Tony-Stank-shift/Rescue-team/docs/vision/vision_photos/图4.png

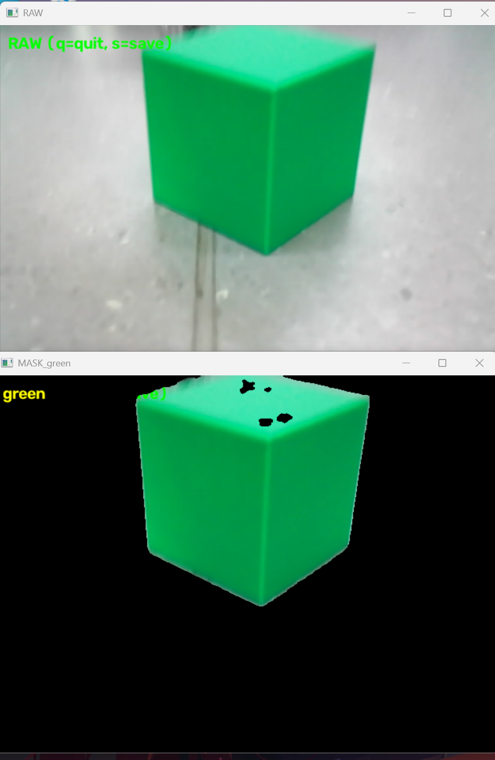
docs/vision/vision_photos/图4.png
