Tony-Stank-shift/Rescue-team/docs/vision/vision_photos/图3.png

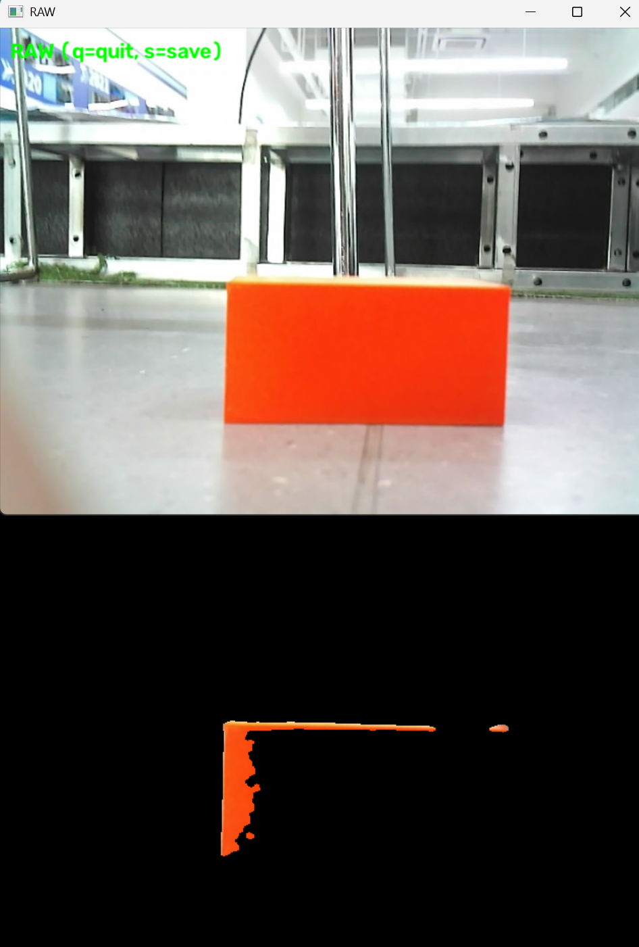
docs/vision/vision_photos/图3.png
