Tony-Stank-shift/Rescue-team/docs/GRIPPER_V2_GEOMETRY.md

# 夹爪 V2 机构几何与标定（2026-09-16 机构变更）

> **为什么有这份文档**：夹爪从旧"U 型槽 + 舵机带单块后方板渐进上调"改为
> "**150×100 方形套框 + 后方三块水平阶梯板**"。开口尺寸与板子高度直接决定
> `config.Placement` 的几个常量，而这些常量**填错就是现场套不住/放不进**。
> 本文记录**从 STL 实测得到的硬数据**、每个受影响的代码点、以及**只能真机标定**
> 的剩余项与标定方法。

---

## 1. 机构描述（机构组 2026-09-16 确认）

| 项 | 内容 |
|---|---|
| 套取方式 | **不变**：自上而下套住目标 |
| 舵机行程 | 实机标定：`0°` 套住 / `85°` 释放（对齐下位机 `servo.h`） |
| 套取开口 | **150mm(横向) × 100mm(前后)** 的方形框（旧描述里的"U 型槽"已不存在） |
| 后方阶梯板 | **三块平行于地面的水平实心板**，自上而下依次变小 |
| 单趟容量 | **1**（机构组确认，未变） |
| 板子分工 | **上板 + 中板** → 推 **橙色长方体（伤员）**、**绿色正方体（普通物资）**<br>**下板（最小）+ 中板** → 推 **黑色三棱锥（核心物资）** |

> 阶梯板是**固定件**：哪块板受力由目标高度决定，属被动机构，**软件无需选择**。
> 变化在于——旧代码里"舵机带着单块后方板**渐进上调**跨过紫边斜坡"的那套动作，
> 其**升降来源已由舵机改为这三块固定阶梯板**（详见 §4）。

---

## 2. 实测数据（源：`装配体3 - 夹爪-2-2.STL`）

测量方法可复现：`python3 tools/stl_gripper_probe.py "<STL 路径>"`

```
三角形 2600 个（二进制 STL，130084 字节，无退化面）
```

### 2.1 包围盒

| 轴 | 范围 (mm) | 跨度 | 含义 |
|---|---|---|---|
| **X** | 58.55 .. 218.55 | **160.00** | 横向（车体左右） |
| **Y** | 14.23 .. 74.89 | **60.66** | **竖直（上）** |
| **Z** | 1215.35 .. 1360.35 | **145.00** | 纵深（车体前后） |

### 2.2 坐标系是怎么定出来的（重要，别再搞错）

STL 里**没有**任何坐标轴元信息，一开始按"Z 向上"解读时三块板的大小**毫无规律**。
判据是：**只有以 Y 为"上"**时，三块水平板的尺寸自上而下恰好是
`157×40 → 150×35 → 150×20`，**依次递减**，与机构组"从上往下依次变小、
最下面最小"的描述完全吻合；换任何别的轴都得不到该规律。
同时该解读下开口尺寸正好是 **150.0 × 100.0**，与"15cm×10cm"一致。

⚠️ Z 从 1215 起，说明该装配体是**在整机装配坐标下建模**的，
故板子的**绝对离地高度未知**，安装偏置须真机实测（见 §5）。

### 2.3 套取开口

由两片侧壁与上下两面围成：

| 面 | 法线 | 尺寸 | 位置 |
|---|---|---|---|
| 左侧壁 | (1,0,0) | Y 10 × Z 100 | X = 63.5 |
| 右侧壁 | (1,0,0) | Y 10 × Z 100 | X = 213.5 |
| 前面 | (0,0,1) | X 150 × Y 10 | Z = 1355.3 |
| 后面 | (0,0,1) | X 160 × Y 10 | Z = 1360.3 |

→ **开口 = 横向 150.0mm（X 63.5..213.5）× 前后 100.0mm（Z 1255.3..1355.3）**，
竖直方向约 10mm（套框套住目标顶部的深度）。

### 2.4 后方三块水平阶梯板

| 板 | 厚度方向位置 (Y) | 长 (X) | 宽 (Z) | 与描述 |
|---|---|---|---|---|
| **上板**（最大） | 29.0 .. 32.0 | **157** | **40** | 上板 + 中板 → 伤员/普通物资 |
| **中板** | 23.2 .. 25.5 | **150** | **35** | 上板+中板 与 下板+中板 **共用** |
| **下板**（最小） | 16.5 .. 16.7 | **150** | **20** | 下板 + 中板 → 核心物资 |

三块板上表面高度差 ≈ 6~7mm、顶面高度约在 Y 17 / 24 / 30，
即**自上而下递减**，与"从上往下大小依次减小、最下面最小"一致 ✅

> 探测脚本的水平面分层表里，某些高度会同时出现**外框边沿**与**内板**的共面
> 三角形而被并成一层（例如 Y 23~25 会显示 160×110）——那是最外框的轮廓，
> 不是中板。板的真实长宽以本节表格（读自竖直面 + 共面两面配对）为准。

---

## 3. 受影响的代码点与改动

| # | 位置 | 旧 | 新 | 依据 |
|---|---|---|---|---|
| 1 | `config.Placement.SLEEVE_OPENING_MM` | 无（不存在该概念） | `(150.0, 100.0)` | §2.3 实测 |
| 2 | `config.Placement.CAPTURE_RADIUS_MM` | `150.0`（本来硬编码在 `transport_pipeline`） | **`100.0`** | §4.1 推导 |
| 3 | `config.Placement.PROGRESSIVE_RAISE_STEPS` | 硬编码 `_place_steps = 4` | 可配置，默认 `4` | §4.2 |
| 4 | `config_loader.PlacementConfig.drop_forward_mm` | 数据类默认 **`150.0`**（N-6 证明的坏值） | **`70.0`** | 见 §4.3 |
| 5 | `transport_pipeline.drop_position()` 兜底值 | `getattr(..., 150.0)`（误导性坏兜底） | `getattr(..., 70.0)` | 见 §4.3 |
| 6 | `config/robot.default.yaml` | 旧注释 + 无新键 | 三新键 + V2 说明 | — |
| 7 | `config_loader._ROBOT_SCHEMA` | 无新键校验 | 三新键校验 | 防写错静默退化 |
| 8 | 全仓 `U 型槽` 文案 | 7 处 | 改为"套取框 / 夹爪 V2" | 描述已与实物不符 |
| 9 | `sleeve_lift.py` 两个 `place_ramp()` + 类文档 | "U型槽后方实心板渐进上调" | 说明推升来源已是固定阶梯板 | §4.2 |

---

## 4. 关键推导与判断

### 4.1 `CAPTURE_RADIUS_MM`：旧值 150 对新夹爪**必然套空**

`CAPTURE_RADIUS_MM` 是"车心到目标距离小于它就开始下压套取"的闸门。
套取框中心约在车心前方 `DROP_FORWARD_MM = 70mm`，开口**半深 50mm**，因此目标与车心的
前后距离必须落在

```
[70 − 50, 70 + 50] = [20, 120] mm
```

**旧值 150 落在区间之外 → 目标根本不在套取框正下方**，而软件仍会把它记成"已套住"
（视觉确认若未标定也发现不了）——这是与 **S-40 同族的"幽灵捕获"**：记账成功、实车套空，
首趟"必须且仅 1 个普通物资"的闸门被反向废掉。

新值取 **100**：位于合法区间内、距远端边界留 20mm 余量，又不苛求导航精度达到 70。

**仿真安全性已实测**：在 `80 / 100 / 120 / 150` 四个取值下，5 种子仿真结果
**逐位完全一致**（80/7/7/E0、80/7/7/E0、85/8/8/E0…），故该改动不影响回归基线。

> ⚠️ 真机仍需确认：若导航能把目标稳定送到开口中心，可进一步下调到 **70**
> （此时两侧余量各 50mm，最大）。现场改 `config/robot.default.yaml` 的
> `placement.capture_radius_mm` 即可，无需改代码。

### 4.2 `PROGRESSIVE_RAISE_STEPS`：推升来源变了，序列需要现场二选一

旧机构：后方**单块**实心板由舵机带着**渐进上调**，把目标推上 34° 紫边斜坡。
新机构：三块**固定**阶梯板，推升靠**底盘前进**逐级爬升。

因此代码里“推入过程中舵机 0°→85° 分 4 步渐进抬”这一动作，
其**原有升力作用已消失**，只剩下"渐进卸力"的效果。两种序列都可能成立：

- `4`（默认，保留旧行为）：推入中分步渐开；
- `0`：推入全程保持 `0°`（套住），到位后一次性释放。

**这是真机标定项**，见 §5-②。改 YAML 即可切换（`placement.progressive_raise_steps`），
无需改代码。

### 4.3 顺手修掉的一个"坏默认值"埋雷

`config_loader.PlacementConfig.drop_forward_mm` 的数据类默认值写的是 **150.0**，
而 N-6 已证明 150 会把落点推到围栏上（真值 70）。`robot.default.yaml` 里写了 70.0
所以生产路径没事，但**任何漏写该项的自定义 robot YAML 都会静默拿到坏值 150**。
已把默认值改为 `70.0`，并把 `drop_position()` 里同样写死 150.0 的误导性兜底改为 70.0。

（同类问题本轮已核查：`getattr(cfg_placement, "DROP_FORWARD_MM", 150.0)` 中
`cfg_placement` 是 `config.Placement` **类**、属性必定存在，故**实际取到 70**，
过去并未真的用错——实测 `drop_position((0,0,0)) == (70.0, 0.0)` 确认。）

---

## 5. 只能真机标定的剩余项（现场按序做）

| # | 项 | 在哪改 | 怎么标 |
|---|---|---|---|
| ① | **`SLEEVE_ROI`**（套取框在相机图像中的区域） | `config/robot.default.yaml` → `perception.camera.sleeve_roi` | **最高优先级**：框没标定 → 视觉确认必失败 → 机器人卡在"失败→重试→放弃"死循环。把目标放进框，截图量框在 640×480 里的归一化 (x1,y1,x2,y2)。框变大了，旧值 `(0.32,0.55,0.68,0.98)` 大概率要改 |
| ② | **`PROGRESSIVE_RAISE_STEPS`** | `placement.progressive_raise_steps` | 分别试 `4` 与 `0`，看哪种能让目标稳定爬上紫边斜坡且不中途掉落 |
| ③ | **`CAPTURE_RADIUS_MM`** | `placement.capture_radius_mm` | 先用 100；把目标放好，手动把车开到目标正下方，量车心到目标的前后距离 → 该值应等于它；若导航偏差大就调到实测值，**绝不可 > 120** |
| ④ | **`DROP_FORWARD_MM`** | `placement.drop_forward_mm` | 目标套在框里时量车心到它的前伸距离。仍是首趟成败的决定项（见 N-6） |
| ⑤ | **`PUSH_DIST_MM`** | `placement.push_dist_mm` | 推入斜坡的距离，看目标能不能完全进到围栏内侧 |
| ⑥ | 舵机行程时间 | `sleeve_lift.MOVE_TIME_S` / `move_time_s` | 量 `SERVO,LOWER` 到实际到位的时间；**T0-6 修好串口接收缓冲后 `ACK,SERVO,LOWER` 的到达时序已变，必须重测** |
| ⑦ | 相机 `TILT_DEG` / `HEIGHT_MM` | `perception.camera.*` | 与夹爪无关，但同为未标定项（见审计 T3-19） |

---

## 6. 复现命令

```bash
# 1) 重新测量 STL 几何（机构再改时用）
python3 tools/stl_gripper_probe.py "/mnt/c/Users/.../装配体3 - 夹爪-2-2.STL"

# 2) 确认配置链路把新键读进了代码
python3 -c "
import sys; sys.path.insert(0,'src')
from rescue_robot import config as c
from rescue_robot.innovation.config_loader import RobotConfig
c.apply_robot_config(RobotConfig.from_yaml('config/robot.default.yaml'))
print(c.Placement.SLEEVE_OPENING_MM, c.Placement.CAPTURE_RADIUS_MM,
      c.Placement.PROGRESSIVE_RAISE_STEPS, c.Placement.SLEEVE_MAX_HOLD)"

# 3) 回归（改机构参数后必跑）
python3 -m compileall -q src/rescue_robot tools
PYTHONPATH=src python3 tools/fix_verifiers/run_all.py
python3 tools/hw_selftest.py --mock
PYTHONPATH=src python3 tools/fix_verifiers/snapshot_sim.py   # 基准 80/80/80/85/80
```
