Tony-Stank-shift/Rescue-team/tools/vision_vectors/README.md

# tools/vision_vectors —— 视觉识别测试向量集（⚠️ **未完成 / 待现场继续**）

> ## 状态标注（必读）
>
> **本目录是"脚手架"，不是"已验证的结论"。**
>
> 它由 AgentTeams 的 t15 任务建立，但该任务在**结项阶段被需求方主动取消**（为缩短关键路径），
> 因此：
> - **代码可运行**：`run_vectors.py` 在本机能跑通并给出有意义的输出（exit 0）；
> - **但结论未闭环**：逐样本"期望 / 实际 / 是否一致"的对照表、`通过 N/M` 的汇总、
>   以及 HSV 现场标定对照表**都没有写完**，`docs/vision/VISION_VECTORS.md` **未产出**；
> - **不得**把本目录的输出当作"识别已达标"的验收证据。它现在的用途是：
>   ① 作为**现场用 `tools/vision_calibration.py` 标定 HSV 的标尺**；
>   ② 作为后续继续完善测试向量集的**起点**。
>
> 需求方（软件负责人）的指示原文是："一并提交并加注『未完成/待现场继续』"。

## 目录内容

| 文件 | 作用 |
|---|---|
| `generate_vectors.py` | 确定性合成图生成（固定种子、不依赖摄像头/网络），产出 `img/*.png` |
| `samples.py` | 样本定义（颜色 × 形状 × 尺寸，含回归样本） |
| `run_vectors.py` | 逐样本跑当前 `detection.py` 的 HSV 判定，打印颜色中心与命中的桶 |
| `vectors.json` | 向量清单（schema / 生成者 / 是否确定性 / 帧尺寸 / 底色） |
| `img/` | 生成的样本图（36 个） |

## 现场怎么用

```bash
# 1) 看当前阈值对这批样本的判定（不需要相机）
PYTHONPATH=src python3 tools/vision_vectors/run_vectors.py

# 2) 用真实相机标定 HSV（现场灯光下）
python3 tools/vision_calibration.py
```

`run_vectors.py` 的输出里有两类**现场必须知道**的信息：

1. **参与检测的颜色桶是有顺序的**：初赛/决赛当前都是
   `['LIGHT_BLUE', 'GREEN', 'BLACK', 'ORANGE']`。
2. **BLUE 与 LIGHT_BLUE 的 HSV 桶在 H∈[95,110] 区间重叠**，重叠区由**检测顺序**决定取
   `LIGHT_BLUE`（即被判成**危险目标**）。这是**必须现场标定**的项目：真机的浅蓝与蓝
   在该区间本质重叠，只能靠"浅蓝先检测 + 分类器禁止容差命中 DANGEROUS"两道闸门区分
   （见 `docs/audit/FIXES.md` 的待现场标定表）。

## 已知回归样本（延续 t15 的设计意图，供继续完善时使用）

| 样本 | 为什么必须有 |
|---|---|
| `vec_04_*_orange_cuboid_80x40.png` | 80×40 扁盒 → 必须是 `CUBOID`。旧实现与立方体判据重叠会判成 `CUBE` → **伤员必误判（丢 15 分/个）** |
| `vec_03_normal_lightblue_dangerous*.png` | 纯饱和蓝 / 浅蓝 → **绝不能**判成 `DANGEROUS` |
| `vec_05_orange_cuboid_front40x40.png` | 长方体 80 面正对短边（投影 40×40）—— **单目轮廓无法与正方体区分**，这是已知的**根本不可区分项**，需靠颜色 + 比赛阶段组合裁决 |

## 继续完善时请补齐

1. 逐样本对照表（期望 / 实际 / 是否一致）+ `通过 N/M` 汇总，数字必须脚本真跑出来；
2. `docs/vision/VISION_VECTORS.md`（对照表 + RGB↔HSV 实测表 + 现场标定建议）；
3. 决赛形状（圆柱 / 圆锥台 / 长方体 / 球）的样本覆盖；
4. 把"根本不可区分"的两条写进正式结论：
   - 单目轮廓无法区分「长方体 80 面正对短边（投影 40×40）」与「正方体」；
   - 「立方体 vs 球」的圆度不可分。
