Tony-Stank-shift/Rescue-team/MEMORY.md

# MEMORY.md —— 软件任务清单

> **智能救援机器人 · 软件负责人**
> 本文档列出软件负责人需要完成的所有任务，按模块和优先级组织。
> 核心约束：**一键启动后完全自主运行，无任何人为了预。**

---

## 目录

- [0. 核心约束与运行架构](#0-核心约束与运行架构)
- [1. 感知模块](#1-感知模块)
- [2. 自主导航模块](#2-自主导航模块)
- [3. 转运控制模块](#3-转运控制模块)
- [4. 决策与状态机](#4-决策与状态机)
- [5. 对抗策略模块](#5-对抗策略模块)
- [6. 通信模块](#6-通信模块)
- [7. 创新实践适配](#7-创新实践适配)
- [8. 系统健壮性](#8-系统健壮性)
- [9. 开发工具链与测试](#9-开发工具链与测试)
- [10. 软件里程碑](#10-软件里程碑)

---

## 0. 核心约束与运行架构

### 0.1 最关键约束

```
┌──────────────────────────────────────────────────────────────┐
│  ⚠️ 一键启动：机器人上须有明确标识的物理按钮，只有一次启动机会  │
│  ⚠️ 启动后完全自主：不能触碰机器人、不能触碰笔记本电脑        │
│  ⚠️ 不允许任何形式的遥控                                       │
│  ⚠️ 禁止抓取救援目标、禁止将目标放置在机器人上                 │
│  ⚠️ 转运方式只能为推 / 拨 / 铲                                │
└──────────────────────────────────────────────────────────────┘
```

### 0.2 两阶段运行模式

```
【调试配置阶段 — 3 分钟】              【全自主运行阶段 — 3 分钟】
                                      
  上电、传感器初始化                    按下物理按钮 → 一键启动
  传感器校准（IMU、摄像头白平衡）       模式切换：DEBUG → AUTONOMOUS
  与笔记本通信配置参数                  锁定所有外部输入
  系统自检（全传感器 + 电机检查）       实时 感知 → 决策 → 执行 循环
  放置到出发区，进入待机                完全自主运行
  等待裁判开始指令                      比赛结束 → 安全停止
```

### 0.3 软件状态机顶层设计

```
                    ┌─────────────┐
                    │  BOOT       │ 上电初始化
                    │  系统自检    │
                    └──────┬──────┘
                           │ 自检通过
                    ┌──────▼──────┐
                    │  DEBUG      │ 调试模式
                    │  配置/校准   │ ←→ 笔记本通信
                    └──────┬──────┘
                           │ 一键启动（不可逆）
                    ┌──────▼──────┐
                    │  AUTONOMOUS │ 全自主运行
                    │  锁定输入    │
                    └──────┬──────┘
                           │
          ┌────────────────┼────────────────┐
          ▼                ▼                ▼
   ┌─────────────┐ ┌─────────────┐ ┌─────────────┐
   │ FIRST_TRIP  │ │ FREE_RUN    │ │ FORCED_RST  │
   │ 首次转运     │→│ 自由转运     │←│ 被强制分离    │
   │ 1个普通物资  │ │ ≤3个/次    │ │ 回出发区重来  │
   └─────────────┘ └──────┬──────┘ └─────────────┘
                           │ 时间将尽 / 目标全清
                    ┌──────▼──────┐
                    │  END        │ 比赛结束
                    │  安全停止    │
                    └─────────────┘
```

### 0.4 需要实现的具体任务

- [x] 实现 BOOT → DEBUG → AUTONOMOUS 三态切换
- [x] 一键启动按钮的 GPIO 中断处理（防抖动、防误触）
- [x] 启动后锁定：禁用所有通信接收、禁用调试接口
- [x] 系统自检流程：传感器数据流检查、电机响应检查、电源电压检查
- [x] 启动失败处理（如传感器未就绪 → LED 指示错误，不启动）
- [x] **15秒防停保活**：分级看门狗(10s→探索/13s→保命)，不再直接淘汰

---

## 1. 感知模块

### 1.1 目标识别与分类

**功能描述**：识别场地上的救援目标，区分为四类并输出位置。

| 任务 | 详细要求 | 优先级 |
|---|---|:---:|
| 颜色识别 | 红、黄、蓝、橘、绿、棕、黑、浅蓝、白等 | P0 |
| 形状识别（初赛） | 正方体(40mm)、正三棱锥(40mm)、长方体(80×40×40mm) | P0 |
| 形状识别（决赛） | 圆柱体(φ40×60mm)、圆锥台(φ40×φ30×60mm)、长方体(80×40×40mm)、球体(φ40mm) | P0 |
| 目标分类 | 普通物资 / 核心物资 / 伤员 / 危险目标 | P0 |
| 目标定位 | 目标在场地坐标系中的 (x, y) 坐标 | P0 |
| 目标姿态估计 | 目标朝向（判断是否可推动） | P1 |

**关键挑战**：
- 初赛和决赛目标形状**完全不同**，需要两套识别模型或强泛化模型
- 颜色可能有**色差**，光照条件不确定
- 目标摆放位置和姿态**随机**
- 实际尺寸和颜色以现场为准，与文档描述可能有偏差

### 1.2 场地环境感知

| 任务 | 详细要求 | 优先级 |
|---|---|:---:|
| 安全区颜色识别 | 区分**红色**安全区和**蓝色**安全区 | P0 |
| 物资区/伤员区识别 | 安全区内分隔板识别，判断物资区 vs 伤员区 | P0 |
| 紫色围栏检测 | 安全区面场地侧紫色三角形截面围栏 | P0 |
| 出发区识别 | 洋红色出发区（1-4 号） | P1 |
| 场地边界检测 | 四周围栏（高 < 100mm） | P0 |
| 减速带检测 | 出发区前 3 根减速带（间隔 50mm） | P0 |
| 障碍物检测 | 场地上的静态障碍物 | P1 |

### 1.3 对方机器人感知

| 任务 | 详细要求 | 优先级 |
|---|---|:---:|
| 对方机器人检测 | 识别对方机器人的位置 | P0 |
| 对方机器人跟踪 | 持续跟踪对方运动轨迹 | P0 |
| 对方意图预测 | 预测对方下一步目标（用于争夺策略） | P2 |
| 接触检测 | 检测是否与对方发生物理接触 | P0 |

### 1.4 多模态传感器融合

| 任务 | 详细要求 | 优先级 |
|---|---|:---:|
| 温度传感器 | 辅助目标识别（可能有温度差异） | P2 |
| 振动传感器 | 碰撞检测、越障检测 | P2 |
| 二维码/条码读取 | 场地布置中可能的信息标识 | P2 |
| 文字/图像识别 | 场地标记、目标上附着的文字/图像 | P2 |
| **多传感器融合** | 视觉 + IMU + 里程计融合建图定位 | P0 |

### 1.5 动态目标地图

> ⚠️ **易被忽略的关键点**：无效转运的目标会被裁判**取出重新随机放置在场地中央**，目标地图不是静态的。

| 任务 | 详细要求 |
|---|---|
| 全局目标地图维护 | 持续跟踪所有已知目标的位置和状态 |
| 目标消失检测 | 检测已被转运/被移除的目标 |
| 新目标检测 | 检测被裁判重新放入场地中央的目标 |
| 地图更新策略 | 定时全扫描 vs 事件驱动更新 |
| 目标计数 | 已转运几个、场上还剩几个（用于时间策略） |

---

## 2. 自主导航模块

### 2.1 定位

| 任务 | 详细要求 | 优先级 |
|---|---|:---:|
| 场地 SLAM | 3000×3000mm 范围内的实时定位 | P0 |
| 初始定位 | 从出发区确定自身在场地中的位置 | P0 |
| **重定位** | 被强制分离后放回出发区，需重新确定位置 ⚠️ | P0 |
| 定位精度 | 目标在 cm 级别，确保转运精度 | P0 |
| 定位丢失恢复 | 传感器遮挡/失效时的退化处理 | P1 |

### 2.2 路径规划

| 任务 | 详细要求 | 优先级 |
|---|---|:---:|
| 全局路径规划 | A* / RRT 等算法，从当前位置到目标位置 | P0 |
| 局部避障 | 动态避开对方机器人和新发现的障碍物 | P0 |
| 路径优化 | 最小化空驶距离，提高转运效率 | P1 |
| 多目标路径 | 一次规划多个目标点的最优路径 | P1 |

### 2.3 运动控制

| 任务 | 详细要求 | 优先级 |
|---|---|:---:|
| 底盘驱动 | 全向/差速驱动控制 | P0 |
| 高速移动 | 在安全前提下尽可能快 | P0 |
| 精确对准 | 接近目标/安全区时的低速精确控制 | P0 |
| **越障控制** | 跨越 3 根减速带（不可绕过） | P0 |
| 防打滑 | 避免原地打滑损坏场地 | P1 |

### 2.4 禁区管理

| 任务 | 详细要求 | 优先级 |
|---|---|:---:|
| 对方安全区检测 | 不能进入对方安全区（**含压在围栏上**） | P0 |
| 对方安全区避让 | 路径规划中标记为禁区 | P0 |
| 场地边界遵守 | 不能驶出场地围栏 | P0 |
| 扣分规避 | 每次进入对方安全区 **-5 分**，可累加 | P0 |

---

## 3. 转运控制模块

### 3.1 转运机构控制

> ⚠️ **关键约束**：禁止抓取、禁止将目标放置在机器人上。只能用推/拨/铲方式。

| 任务 | 详细要求 | 优先级 |
|---|---|:---:|
| 推拨机构控制 | 推板/拨杆/铲斗的运动控制 | P0 |
| 目标接近策略 | 从哪个角度接近目标、用什么速度 | P0 |
| 防推动失败 | 目标翻滚/滑脱时的重试逻辑 | P1 |
| 力控制 | 力度适中，不损坏目标、不推出场地 | P2 |

### 3.2 数量管理

| 任务 | 详细要求 | 优先级 |
|---|---|:---:|
| **单次装载计数** | 当前这一趟推了几个目标（≤3） | P0 |
| **首次转运判定** | 是否是第一次转运（必须恰好 1 个普通物资） | P0 |
| **伤员单独转运判定** | 转运伤员时确保数量为 1 | P0 |
| 超限检测 | 超过 3 个或伤员超过 1 个 → 本轮结束 ⚠️ | P0 |
| 危险目标过滤 | 绝对避开浅蓝正方体/球体 | P0 |

### 3.3 安全区投放

| 任务 | 详细要求 | 优先级 |
|---|---|:---:|
| **物资→物资区** | 普通/核心物资放入物资区 | P0 |
| **伤员→伤员区** | 伤员放入伤员区 | P0 |
| **放错检测与预防** | 物资入伤员区或反之 = **-10 分/个** | P0 |
| "全部进入"判定 | 目标完全进入安全区内（不含围栏上）才算成功 | P0 |
| 投放精度 | 确保投放后目标不会被弹出 | P1 |

---

## 4. 决策与状态机

### 4.1 核心状态机

```
FIRST_TRIP（首次转运）
  │  规则：必须且仅转运 1 个普通物资至本队安全区物资区围栏内侧
  │  违规（>1 个无效 或 转运了非普通物资） → 本轮结束
  │  成功条件：1 个普通物资进入物资区围栏内侧
  │
  ▼
FREE_RUN（自由转运）
  │  规则：
  │  · 一次转运 ≤ 3 个救援目标（超过 → 本轮结束）
  │  · 可同时转运普通物资 + 核心物资
  │  · 伤员必须单独转运（1 个/次）
  │  · 危险目标绝对禁止触碰
  │
  ├── 时间充裕 → 优先取高分目标（伤员 15 > 核心 10 > 普通 5）
  │
  ├── 时间将尽 → 放弃低分目标，确保已装载目标完成投放
  │
  └── 所有救援目标全清 → 比赛结束
```

### 4.2 需要实现的具体任务

| 任务 | 详细要求 | 优先级 |
|---|---|:---:|
| FIRST_TRIP 状态实现 | 只允许推 1 个普通物资，其他目标绕开 | P0 |
| FREE_RUN 状态实现 | 混合转运逻辑 + 单独伤员逻辑 | P0 |
| 首次转运完成判定 | 确认 1 个普通物资已在物资区围栏内侧 | P0 |
| 目标优先级排序 | 伤员 > 核心物资 > 普通物资（考虑距离成本） | P0 |
| 时间管理策略 | 3 分钟倒计时，剩余时间不足时切换保守策略 | P1 |
| **转运无效后的恢复** | 裁判取走无效目标 → 更新地图 → 继续运行 | P1 |

### 4.3 强制分离恢复（重要边缘情况）

> 接触超过 10 秒 → 裁判将两台机器人放回各自出发区 → 计时不中断 → 继续运行

| 任务 | 详细要求 | 优先级 |
|---|---|:---:|
| **强制分离检测** | 判断是否被裁判移动了位置 | P0 |
| **出发区重定位** | 从任意出发区重新确定自身位置 | P0 |
| **任务状态保持** | 保留已完成的任务进度（不重置状态机） | P0 |
| **继续运行** | 从出发区重新出发，继续未完成的任务 | P0 |
| 多次分离处理 | 一场比赛可能被分离多次 | P1 |

### 4.4 异常检测与处理

| 任务 | 详细要求 | 优先级 |
|---|---|:---:|
| **分级看门狗保活** | 10s无动作→探索; 13s→保命; 15s→最后防线, **不淘汰** | P0 |
| 失控检测 | IMU 异常、电机不受控 → 降级保命 | P0 |
| 传感器故障降级 | 某个传感器失效时用其他传感器补偿 | P1 |
| 卡死检测与脱困 | 被障碍物或对方卡住时主动脱困 | P1 |

> ⚠️ **15秒不再导致淘汰。改为四层降级保活链 (Level 0→4)。**

### 4.5 四层降级保活链

> **核心思想**：机器人永远不能停。遇问题逐级降级，确保一直有动作。

| 层级 | 触发条件 | 行为 | 看门狗联动 |
|:----:|---|---|:---:|
| Level 0 | 正常 | 感知→决策→导航→转运 | <10s |
| Level 1 | 单次失败 | 重试（换角度/降速/重夹取, 最多3次） | — |
| Level 2 | 3次重试失败 | 放弃当前目标，选下一个最优 | — |
| Level 3 | 无目标/路径阻断 | **探索模式**：驶向场地随机位置，边移动边扫描 | ≥10s |
| Level 4 | 13s无动作 | **保命运动**：低速绕圈，只要动就不会淘汰 | ≥13s |

**降级恢复**：一旦恢复移动或检测到目标，自动回到 Level 0。

| 场景 | 原行为 | 新行为 |
|---|---|---|
| A* 路径被阻断 | 停止不动 → 15s淘汰 | 自动换目标 / 探索 |
| 未检测到目标 | WAIT等待 → 15s淘汰 | 向场地中央移动扫描 |
| 夹取失败 3 次 | IDLE等待 → 15s淘汰 | 放弃换目标 |
| 10s 无任何动作 | 等 15s 淘汰 | **立即探索** |
| 13s 无任何动作 | 等 15s 淘汰 | **保命绕圈** |

---

## 5. 对抗策略模块

### 5.1 非进攻性对抗

| 任务 | 详细要求 | 优先级 |
|---|---|:---:|
| **禁止主动进攻** | 软件不能有任何主动冲撞对方的逻辑 ⚠️ | P0 |
| 接触检测 | 识别与对方机器人的物理接触 | P0 |
| **10 秒脱离** | 接触发生后，10 秒内主动脱离（避免强制分离） | P0 |
| 脱离策略 | 后退/绕行，选择最短的脱离路径 | P0 |

### 5.2 目标争夺

| 任务 | 详细要求 | 优先级 |
|---|---|:---:|
| 对方目标预测 | 预测对方正在前往的目标 | P1 |
| 争夺决策 | 对方已接近的目标是否放弃 vs 抢先 | P1 |
| 避让 vs 抢先 | 综合评估距离、目标分值、时间 | P1 |

### 5.3 对方意外行为

| 任务 | 详细要求 | 优先级 |
|---|---|:---:|
| 对方送入目标 | 对方把目标推入我方安全区 → 白得分，**不干扰** | P1 |
| 对方阻挡 | 对方静止挡路 → 绕行而非推撞 | P0 |
| 对方主动进攻 | 检测被攻击 → 避让，不反击（反击 = 本队结束） | P0 |

---

## 6. 通信模块

### 6.1 调试模式通信（允许双向）

| 任务 | 详细要求 | 优先级 |
|---|---|:---:|
| 参数配置协议 | 笔记本 ↔ 机器人：调整识别阈值、策略参数等 | P0 |
| 传感器数据回传 | 实时查看摄像头画面、传感器读数 | P0 |
| 状态监控 | 查看当前状态机状态、目标地图、路径规划 | P0 |
| 日志下载 | 下载历史运行日志 | P1 |

### 6.2 运行模式通信（仅单向广播）

| 任务 | 详细要求 | 优先级 |
|---|---|:---:|
| 状态广播 | 定时发送当前状态（位置、已转运目标数等） | P1 |
| **不接收指令** | 启动后**禁止**接收任何来自笔记本的控制指令 | P0 |
| **不触碰约束** | 队员不能触碰笔记本（通信协议不影响此约束） | P0 |

### 6.3 通信协议设计

| 任务 | 详细要求 |
|---|---|
| 无线方案选型 | WiFi / 蓝牙 / Zigbee 等 |
| 数据格式 | JSON / Protobuf / 自定义二进制 |
| 连接稳定性 | 断线重连、超时处理 |
| 安全机制 | 确保运行模式下不会误接收指令 |

---

## 7. 创新实践适配

> ⚠️ 决赛创新实践环节：现场发布命题 → 更换零部件 → **现场编程调试** → 时间有限

### 7.1 模块化与可配置性

| 任务 | 详细要求 | 优先级 |
|---|---|:---:|
| 参数化配置系统 | YAML/JSON 配置文件：目标颜色/形状、场地参数、策略权重 | P0 |
| 初赛/决赛模型切换 | 一键切换两套目标识别模型 | P0 |
| 硬件抽象层 | 更换零部件后软件可快速适配（如电机参数、传感器标定） | P0 |
| 策略参数热更新 | 不重新编译即可调整策略参数 | P1 |

### 7.2 现场编程效率

| 任务 | 详细要求 | 优先级 |
|---|---|:---:|
| 快速部署流程 | 从修改代码到部署到机器人 < 5 分钟 | P1 |
| 调试可视化工具 | 笔记本端 GUI 查看传感器/状态机（辅助现场调试） | P1 |
| 预设策略模板 | 多套预测试过的策略配置可选 | P2 |

---

## 8. 系统健壮性

### 8.1 故障容错

| 任务 | 详细要求 |
|---|---|
| 传感器降级 | 摄像头故障 → 尝试仅用其他传感器继续；无法继续 → 安全停止 |
| 电机故障检测 | 电机堵转/空转检测 → 记录日志 |
| 通信中断 | 调试模式下通信断开不影响机器人基本运行 |
| 电源监控 | 低电量预警（比赛前充电检查） |

### 8.2 稳定性

| 任务 | 详细要求 |
|---|---|
| **2-3 场比赛稳定性** | 成绩取平均值，每场都重要，不能单场赌博式策略 |
| 长时间运行测试 | 连续 10+ 轮模拟比赛无崩溃 |
| 内存管理 | 3 分钟运行无内存泄漏 |
| 启动成功率 | 一键启动成功率 ≥ 99%（只有一次机会） |

### 8.3 日志与复盘

| 任务 | 详细要求 |
|---|---|
| 运行日志 | 记录完整的传感器数据、决策过程、状态切换（用于赛后分析） |
| 关键事件记录 | 状态切换、违规风险、接触事件等打时间戳 |
| 日志存储 | 本地 SD 卡/Flash 存储，赛后导出 |

---

## 9. 开发工具链与测试

### 9.1 仿真环境搭建

| 任务 | 详细要求 | 优先级 |
|---|---|:---:|
| 场地仿真 | 3000×3000mm 场地模型（含所有区域、围栏、减速带） | P0 |
| 目标仿真 | 四种目标的 3D 模型（初赛 + 决赛两套） | P0 |
| 对手机器人仿真 | 模拟对手行为（随机/对抗/进攻） | P1 |
| 物理引擎 | 碰撞、摩擦、目标推动等物理效果 | P1 |
| 传感器仿真 | 模拟摄像头、IMU、里程计等数据输出 | P0 |

### 9.2 测试体系

| 任务 | 详细要求 |
|---|---|
| 单元测试 | 每个模块独立测试（识别、导航、状态机、控制） |
| 集成测试 | 模块间接口测试、数据流测试 |
| 完整比赛模拟 | 从启动到结束的完整流程自动化测试 |
| 边缘情况测试 | 强制分离、无效目标、首次转运失败等 |
| 压力测试 | 多种初始条件随机组合 |
| 硬件在环测试 | 仿真 + 真实硬件联合测试 |

### 9.3 CI/CD

| 任务 | 详细要求 |
|---|---|
| 代码仓库管理 | Git 分支策略、代码审查 |
| 自动构建 | 代码提交 → 自动编译 → 运行测试 |
| 版本管理 | 比赛用软件版本锁定与备份 |

---

## 10. 软件里程碑

对齐整体项目进度（11 个 Phase），软件负责重点任务：

| Phase | 阶段 | 软件任务 | 产出物 |
|:-----:|---|---|---|
| 1 | 赛题分析 | 需求分析、软件架构设计、技术选型 | 软件架构文档 |
| 2 | 机械设计 | 传感器布局方案、计算平台选型 | 硬件-软件接口定义 |
| 3 | 硬件选型 | 确定传感器型号、安装位置标定方案 | 传感器驱动清单 |
| 4 | 装配调试 | 传感器驱动开发、基础运动控制 | 底盘可动、传感器有数据 |
| 5 | 自主导航 | SLAM、路径规划、避障、越障 | 场地内自主移动 |
| 6 | 目标识别 | 视觉模型训练、多模态融合、动态地图 | 四类目标 >95% 识别率 |
| 7 | 转运控制 | 推拨控制、数量管理、投放精度 | 成功转运目标至安全区 |
| 8 | 对抗联调 | 状态机完整实现、对抗策略、强制分离恢复 | 完整比赛流程可运行 |
| 9 | 文档撰写 | 配合撰写任务命题文档（软件部分） | 文档软件章节 |
| 10 | 模拟比赛 | 仿真全流程测试、边缘情况覆盖、稳定性验证 | 20+ 轮无故障运行 |
| 11 | 正式参赛 | 现场调试预案、应急处理方案、最终版本锁定 | 比赛就绪 |

---

## 附录 A：快速参考 —— 关键数字

| 项目 | 数值 |
|---|---|
| 场地尺寸 | 3000 × 3000 mm |
| 运行时间 | 3 分钟（180 秒） |
| 调试时间 | 3 分钟 |
| 强制分离接触时间 | 10 秒 |
| 无动作停止时间 | 15 秒 |
| 单次最多转运 | 3 个（伤员必须单独） |
| 机器人最大重量 | 1.5 kg |
| 机器人最大尺寸 | 300 × 300 × 200 mm |
| 目标最大尺寸 | 140 mm |
| 目标最大重量 | 800 g |

## 附录 B：快速参考 —— 违规后果

| 违规行为 | 后果 |
|---|---|
| 危险目标入安全区 | **本轮结束** |
| 首次转运 ≠ 1 个普通物资 | **本轮结束** |
| 单次转运 > 3 个 | **本轮结束** |
| 转运伤员 > 1 个 | **本轮结束** |
| 主动进攻 | **本轮结束** |
| 对方安全区内移出目标 | **本轮结束** |
| 物资⇔伤员区放错 | **-10 分/个** |
| 进入对方安全区 | **-5 分/次** |
| 移出场地 | 按种类扣分 |
| 15 秒无动作 | **降级保活，不淘汰**（探索→保命绕圈） |
| 失控 / 起火 / 破坏场地 | **本轮结束 + 取消资格** |

---

> 📝 **本文档随开发进展持续更新。** 每个 Phase 开始前 review 对应任务，完成后勾选。
