Tony-Stank-shift/Rescue-team/docs/hardware/EDA.png

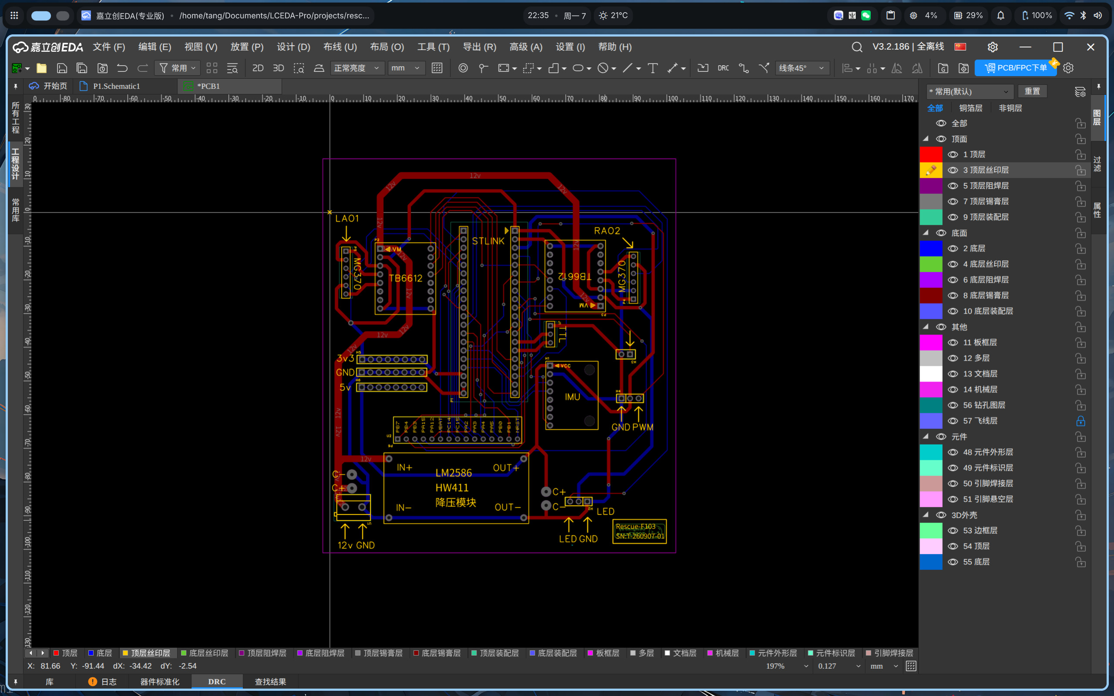
docs/hardware/EDA.png
