Tony-Stank-shift/Rescue-team/docs/scene/field_layout_diagram.png

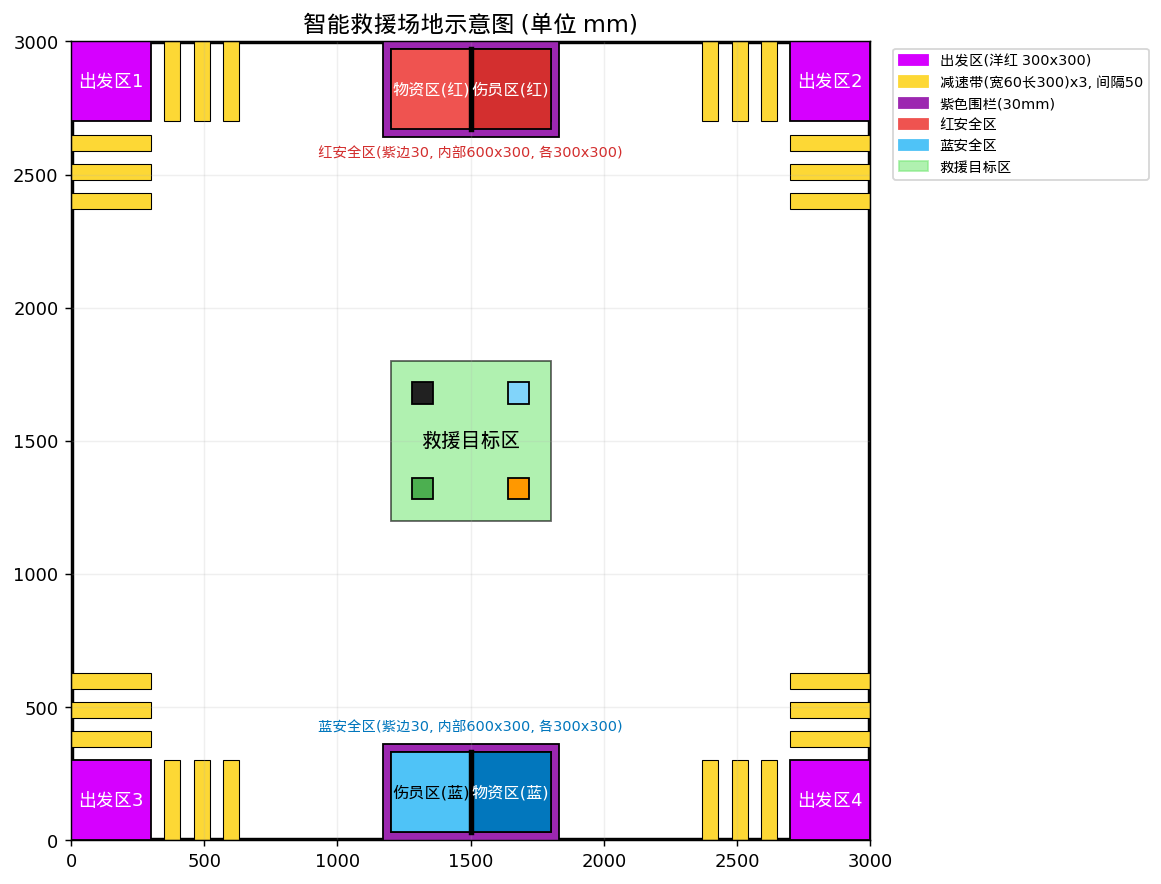
docs/scene/field_layout_diagram.png
