Tony-Stank-shift/Rescue-team/docs/scene/field_layout_v2.png

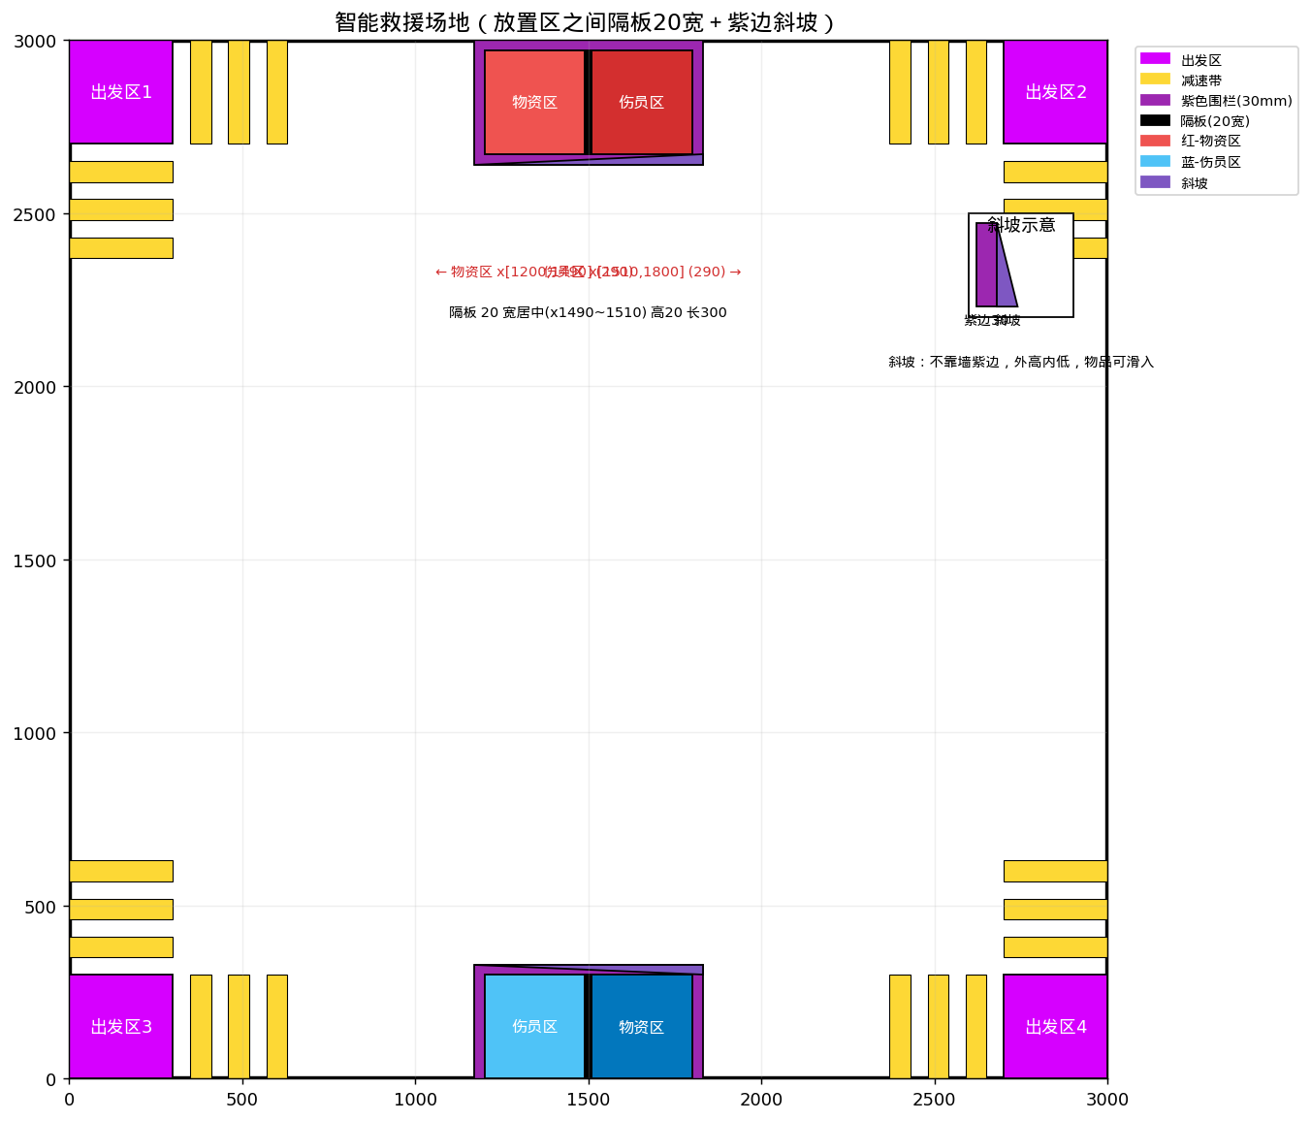
docs/scene/field_layout_v2.png
