Tony-Stank-shift/Rescue-team/docs/scene/pdf_field_page16.png

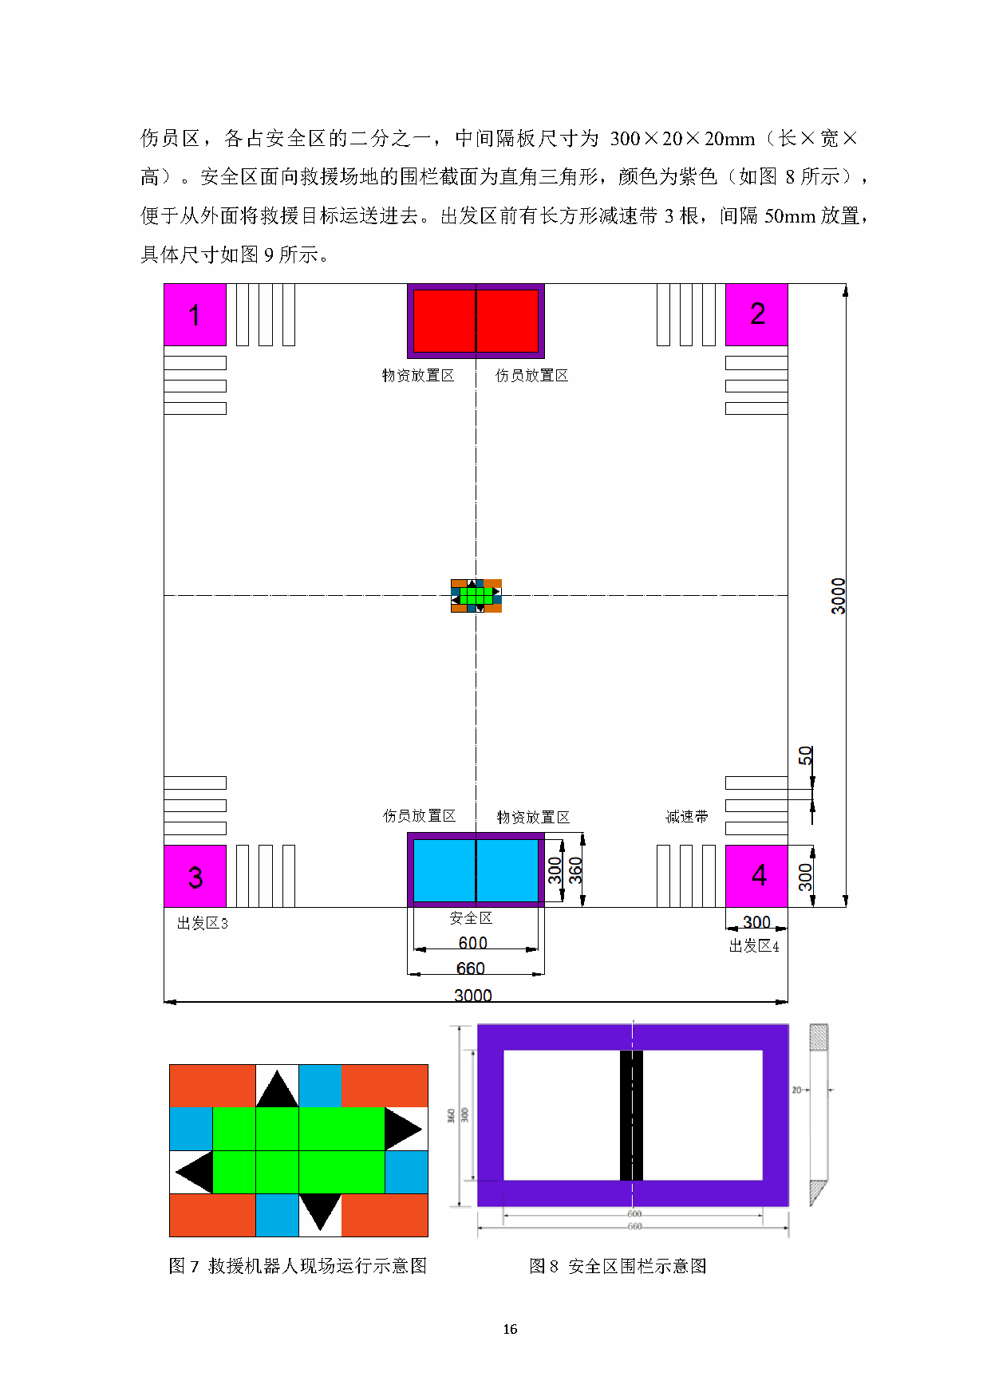
docs/scene/pdf_field_page16.png
