Tony-Stank-shift/Rescue-team/docs/vision/vision_photos/图1.png

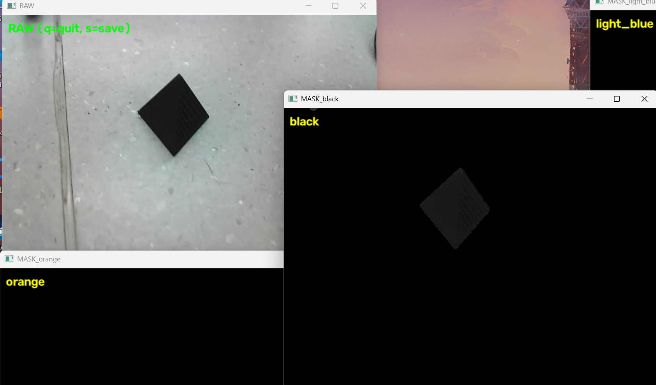
docs/vision/vision_photos/图1.png
