Tony-Stank-shift/Rescue-team/docs/vision/vision_photos/图2.png

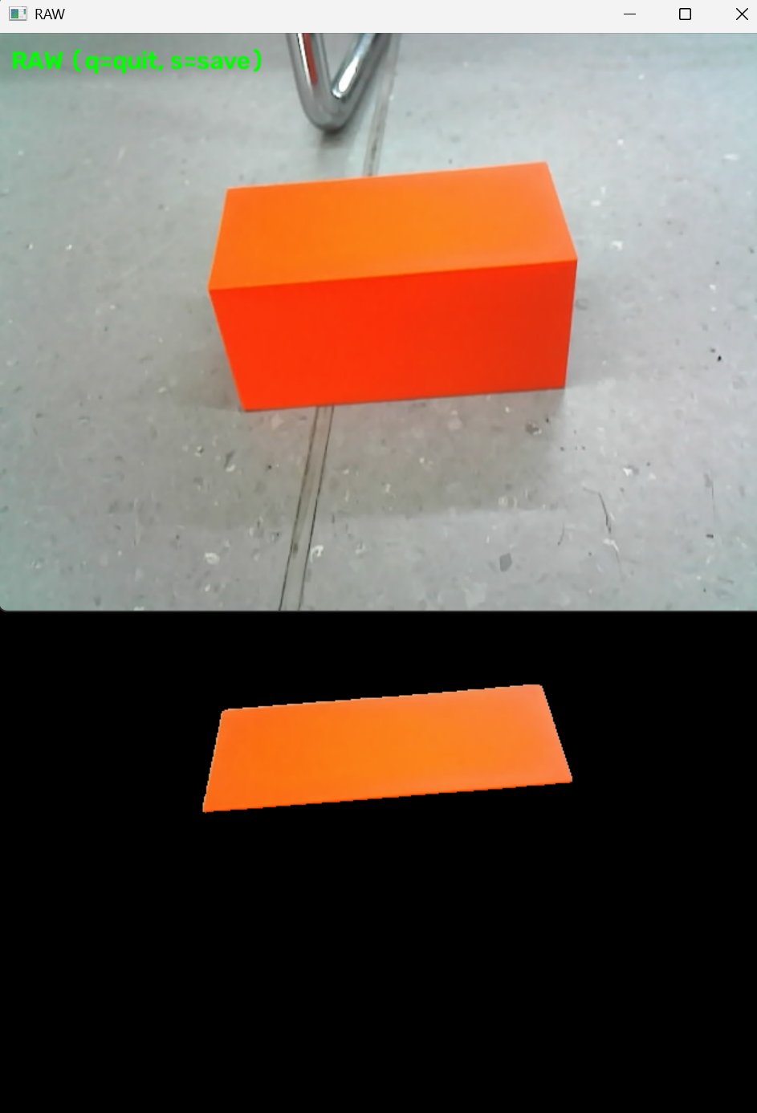
docs/vision/vision_photos/图2.png
