Tony-Stank-shift/Rescue-team/docs/vision/vision_photos/图5.png

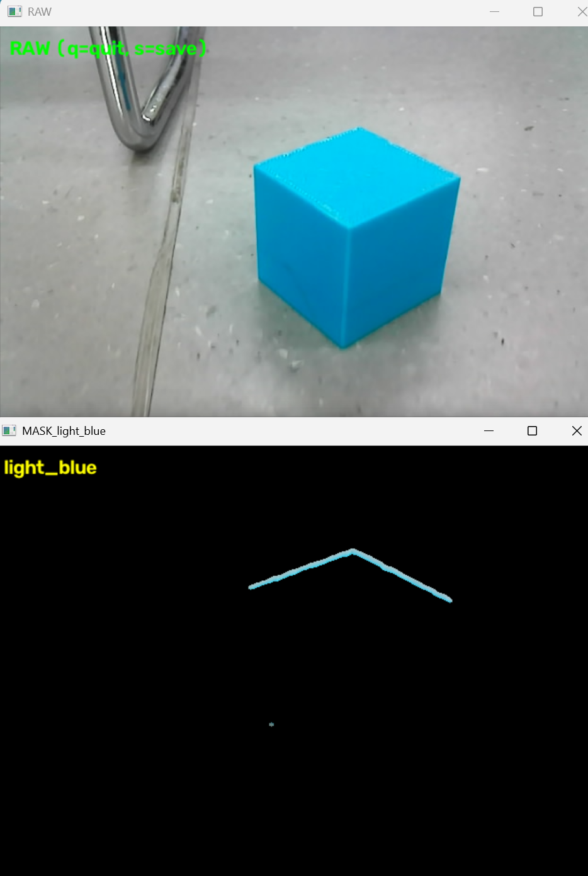
docs/vision/vision_photos/图5.png
