Tony-Stank-shift/Rescue-team/docs/vision/vision_photos/图6.png

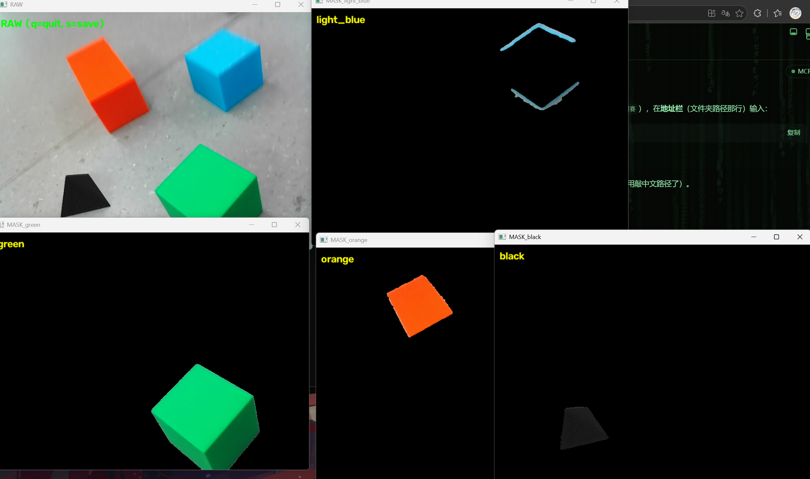
docs/vision/vision_photos/图6.png
