Tony-Stank-shift/Rescue-team/docs/vision/vision_photos/图7.png

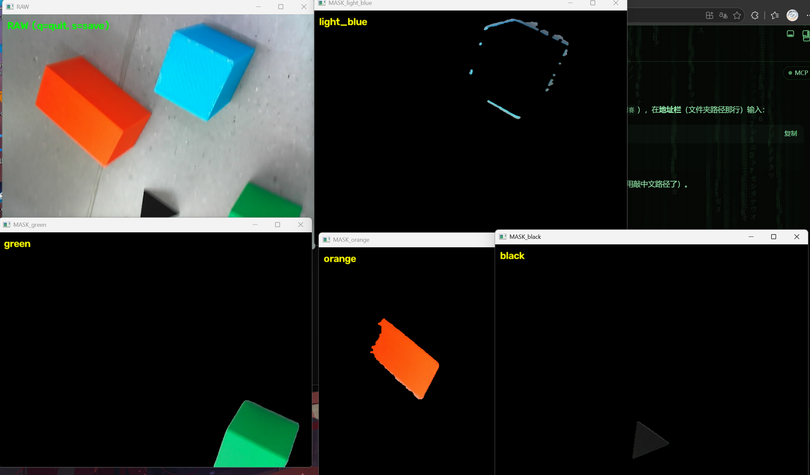
docs/vision/vision_photos/图7.png
