Tony-Stank-shift/Rescue-team/docs/vision/vision_photos/图8.png

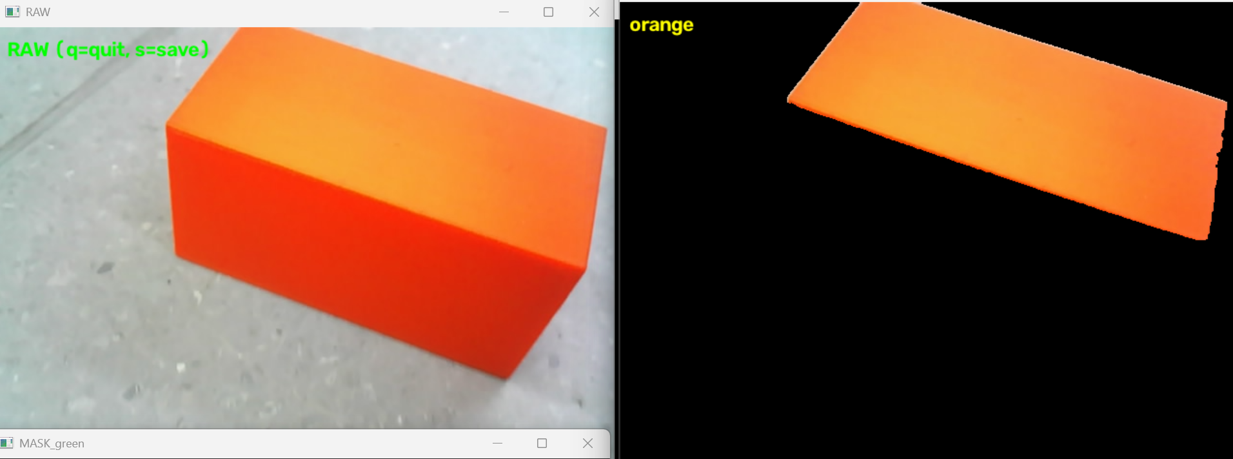
docs/vision/vision_photos/图8.png
