Tony-Stank-shift/Rescue-team/tools/vision_vectors/img/vec_02_normal_black_pyramid.png

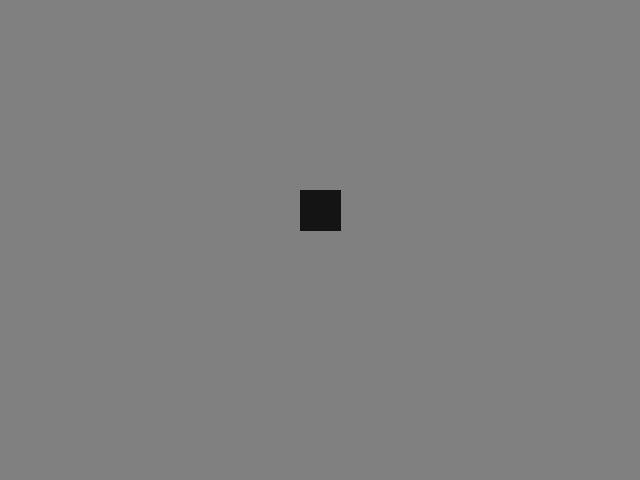
tools/vision_vectors/img/vec_02_normal_black_pyramid.png
