Tony-Stank-shift/Rescue-team/tools/vision_vectors/img/vec_12_white_background.png

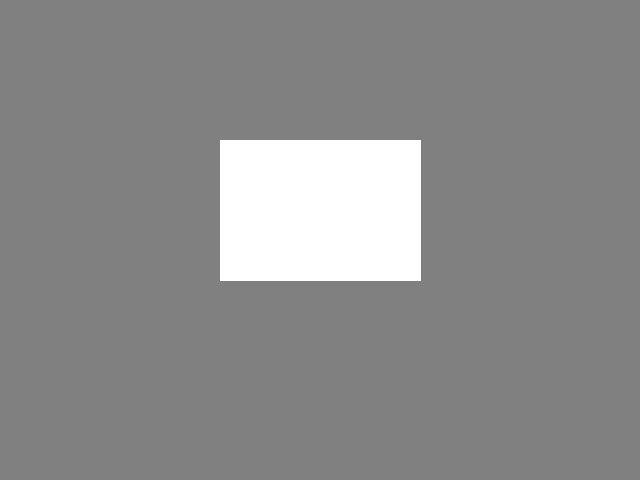
tools/vision_vectors/img/vec_12_white_background.png
