Tony-Stank-shift/Rescue-team/tools/vision_vectors/img/vec_15_lightblue_vs_blue_sbs.png

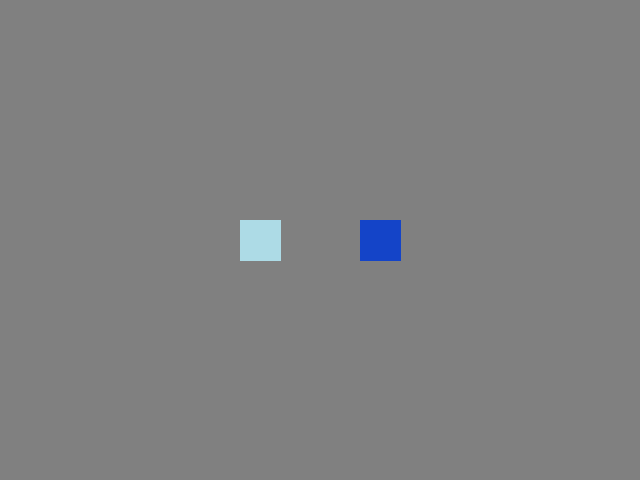
tools/vision_vectors/img/vec_15_lightblue_vs_blue_sbs.png
