Tony-Stank-shift/Rescue-team/tools/vision_vectors/img/vec_19_white_wide.png

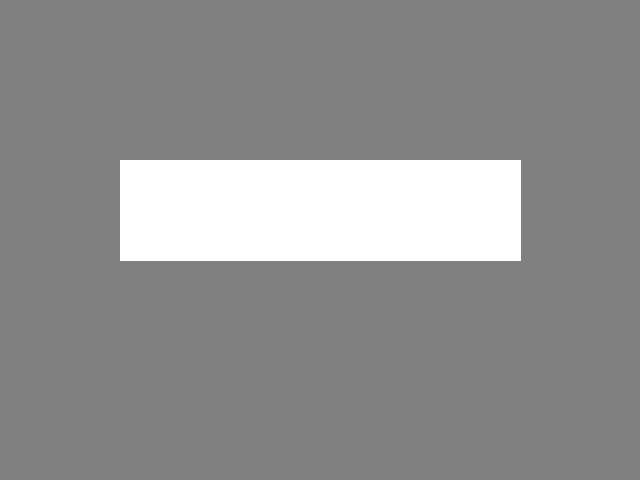
tools/vision_vectors/img/vec_19_white_wide.png
