Tony-Stank-shift/Rescue-team/docs/audit/REAL_MACHINE_DEBUG_20260916.md

# 真机联调排查与修复全记录（2026-09-16）

> **这份文档解决什么问题**：本次把上位机第一次真正接到 RDK + STM32 上跑，
> 过程中出现了一连串"看起来像硬件坏、实际是软件"的故障。每一条都记录了
> **现场现象 → 实测证据 → 根因 → 修复**，目的是让下次现场再遇到同类症状能**直接查表**，
> 而不是从头再猜一遍。
>
> 全轮共修 **9 个问题**，其中 **2 个在 STM32 固件**、**7 个在上位机**。

---

## 0. 环境事实（本轮确认）

| 项 | 值 | 怎么确认的 |
|---|---|---|
| 上位机 | RDK X5，`ubuntu`，Linux 6.1.83 aarch64 | `uname -a` |
| 连接 | 网线直连，`sunrise@192.168.50.2` | `ping` 2.8ms |
| 串口 | **`/dev/ttyS1` @115200**（40PIN UART1） | `/proc/tty/driver/serial` + 实测收发 |
| 引脚复用 | **正确**：GPIO383=RX / GPIO384=TX 属 `uart1grp` | `/sys/kernel/debug/pinctrl/34180000.lsio_iomuxc/pinmux-pins` |
| 相机 | XC-TECH UVC，640×480@16.5FPS | 实拍 + `lsusb` |
| 下位机 | STM32F103，USART1 / **PA9=TX, PA10=RX** / 115200 | CubeMX `.ioc` + `main.c` |
| 固件工具链 | STM32CubeCLT（`AppData/Local/stm32cube/bundles/`） | `CMakeCache.txt` |
| 烧录 | `STM32_Programmer_CLI.exe -c port=SWD -w ...elf -v -rst` | 实测通过 |
| 启动开关 | 下位机 STM32 板上的 **`ON` 自锁开关，接 PB9**（上拉，拨到 ON 拉低） | 协议 §5.1.1 + `main.h` |

---

## 1. 问题清单（9 条）

### 【固件-1】IMU 初始化失败 → 整个 MCU 永久死循环，遥测一字节不发

| 项 | 内容 |
|---|---|
| **现象** | 串口能打开、`rx` 计数**自开机起恒为 0**，上位机表现为"串口故障/接线问题" |
| **证据** | 裸读 `/dev/ttyS1` 3 秒 0 字节；`/proc/tty/driver/serial` 显示 uart1 `rx:0`；换 `cat`/`pyserial` 都一样 |
| **根因** | 固件 `main()` 里 `if (MPU6050_Init(&hi2c2) != HAL_OK) Error_Handler();`，而 `Error_Handler()` 是 `__disable_irq(); while(1){}` **永久死循环**；**`Telemetry_Init()` 排在它后面** → 只要 IMU 没接好/上电时序不巧（`WHO_AM_I != 0x68`），固件就卡在初始化，遥测永远发不出来 |
| **为什么难查** | 电机、串口线、RDK 全是好的，故障点在最不相干的 IMU 支路上 |
| **修复** | 固件改为**降级运行**：`(void)MPU6050_Init(&hi2c2);`（失败不致命）。下游本来就做好守卫：`MPU6050_Update()` 有 `!initialized` 早退、`MPU6050_GetLatestSample()` 无效返回 false、遥测 IMU 行自动跳过 → 没有 IMU 时定位退化为纯里程计，但机器人不再变砖 |
| **状态** | ✅ 已烧录并验证（遥测恢复 84 行/秒） |

### 【固件-2】UART 接收静默死亡（TX 正常），最长静默 6 秒以上

| 项 | 内容 |
|---|---|
| **现象** | 遥测正常流动，但对 `PING`/`START`/`VEL`/`SERVO` **一律不回**（连 `ERR,FORMAT` 都没有），持续数秒后自行恢复 |
| **证据** | 6 轮"开关串口+PING"实测：3/6 轮首次无应答；**第 5 轮连续 3 次（≥6 秒）全部无应答**；而同一时刻下位机仍在发 84 行/秒遥测 |
| **根因** | STM32 HAL 在 ORE（溢出）处理里走 `UART_EndRxTransfer()`，会清掉 `CR1` 的 `RXNEIE/PEIE` 与 `CR3` 的 `EIE`。**`EIE` 一清，后续错误连 `HAL_UART_ErrorCallback` 都不再触发** → `RxState` 停在 `BUSY_RX` 且没有任何中断推动状态机 → 接收永久失效。**而 TX 完全不受影响，所以故障极难察觉** |
| **第一版修复为什么无效** | 我最初写成 `if (RxState != HAL_UART_STATE_BUSY_RX) { 重新武装 }` —— 而故障态**恰恰就是 `BUSY_RX`**，判断直接跳过 |
| **修复** | `Command_Update()` 内加 **RX 健康看门狗**：每 `RX_HEALTH_PERIOD_MS=500ms` **无条件**强制 ①拉回 `READY` ②清 `ErrorCode` 与 ORE ③`HAL_UART_Receive_IT` 重新武装。代价是极小概率丢 1 个在途字节（VEL 50Hz 丢 1 帧无影响，PING/START 有重试） |
| **效果** | 6 秒死窗口消失；最长连续失败从 3 次降到 2 次，每次 2 秒内自愈 |
| **状态** | ✅ 已烧录 |

### 【上位机-1】`START` 不清零里程计 → 累积位移被加到出发区位姿上

| 项 | 内容 |
|---|---|
| **现象** | 进 AUTONOMOUS 后 `A*: 起点 (3973, 2160) 不可通行`（场地只有 3000×3000，即场外约 1 米）→ 路径规划永远失败 → 车一动不动 |
| **证据** | 真机实测发 `START` 前后逐位对比：<br>`前: x=+0.6823 y=+1.0959 θ=-1.7043 enc=(921273,1240079)`<br>`后: x=+0.6823 y=+1.0959 θ=-1.7043 enc=(921273,1240079)`<br>**一模一样** —— 协议 §START 声称"清零局部里程计"，**实际并没有** |
| **根因** | `ChassisInterface.odom_to_upper()` 把 ODOM 当**相对位移**用（`x = _start_x + dx`），而 MCU 上电以来的累积量没被清 → 全部被当成"从出发区走的距离"加上去 |
| **算术复现** | 起点 (2850,2850)：`2850+1096=3946`、`2850-682=2168` ≈ 日志里的 `(3973,2160)` ✓ |
| **修复** | 新增 `set_odom_baseline()`：进 AUTONOMOUS 设起点时**主动记下当前 ODOM 当基线**，换算时先减掉。这样无论下位机清不清零、之前手动测试跑过多少，位姿都能正确归零 |
| **状态** | ✅ 已部署并真机验证 |

### 【上位机-2】旋转角用错参照系（本轮最隐蔽的一条）

| 项 | 内容 |
|---|---|
| **现象** | 位移**大小正确**（1557mm ≈ 1.5m）但**方向整体错**，位姿仍跑到场外 |
| **根因** | `odom_to_upper()` 用 `_start_theta`（**出发区**车头朝向）旋转，但 **ODOM 的 x 轴是「MCU 上电那一刻的车头方向」**。两者相差"从上电到把车摆好之间车被转过多少度"（实测 `θ_基线 = -97.7°`）→ 位移方向整体转错 |
| **修复** | 旋转角改为 `base_theta = θ0 − θ_基线`。**并验证 `θ_基线=0` 时与旧公式逐位一致**（正常情况零影响） |
| **状态** | ✅ 已部署 |

### 【上位机-3】`START_HEADING_DEG` 被 `AutonomousState` 覆盖（本轮修复过程中引入）

| 项 | 内容 |
|---|---|
| **现象** | 日志**自相矛盾**：`main` 打印起点 `+45°`，`autonomous_state` 却打印 `朝向=-90°` |
| **根因** | `main.py` 算好起点后，`autonomous_state.py:117` **又自己算了一遍** `get_start_pose(zone)`，**没带朝向参数** → 把用户设的 +45° 覆盖回默认 -90° |
| **教训** | 加新接口时**没有全局搜索"还有谁在算同一个东西"** |
| **修复** | 抽出公共函数 `field_elements.resolve_start_heading_deg()`，`main.py` 与 `AutonomousState` **统一调用**；已验证两处结果一致 |
| **状态** | ✅ 已部署（**下次开机第一件事是验证它**） |

### 【上位机-4】`start_match()` 一次失败就拒掉整场

| 项 | 内容 |
|---|---|
| **现象** | 进入 AUTONOMOUS 后立刻 `❌ 底盘 START 握手失败 → 拒绝进入自主模式 → 紧急停止` |
| **根因** | `start_match()` 里 PING / START 各只发**一次**、超时 **0.5s**、**不重试**。撞进【固件-2】的静默窗口就直接把整场比赛拒掉 |
| **关键认识** | 静默窗口期间下位机**根本没收到命令**，所以**单纯加长超时是无效的 —— 必须重发** |
| **修复** | 新增通用接口 `send_command_await()`：先 `drain_lines()` 排空残留行，再**重发 4 次 × 1.5s + 0.25s 间隔** |
| **实测验证** | `start_match` 连跑 3 次：**4ms / 3536ms / 5293ms 全部成功** —— 后两次在没有重试的旧代码下必然失败 |
| **状态** | ✅ 已部署并真机验证 |

### 【上位机-5】舵机 ACK 等待同样是"一次 + 0.5s + 不重试"

| 项 | 内容 |
|---|---|
| **现象（预判）** | 会导致"套取总是失败、反复抬爪后退"，**看起来像机构问题，实为通信问题** |
| **修复** | `SerialServoLift.lower()` / `raise_up()` 改用 `_servo_await()`（内部走 `send_command_await`） |
| **状态** | ✅ 已部署，**待真机验证** |

### 【上位机-6】一键启动事件只认一种 → 永久卡在 DEBUG

| 项 | 内容 |
|---|---|
| **现象** | 按 STM32 板上的启动开关**毫无反应**，永久停在 DEBUG |
| **根因** | 固件只在**边沿**发事件且分两种：下位机 `WAIT_START` 时发 `EVENT,START_BUTTON`；**已 `RUNNING` 时只发 `EVENT,BUTTON_LED_ON`**。而我们跑过手动测试让 MCU 变成 RUNNING → 上位机只认前者 → 永远等不到 |
| **修复** | 新增 `read_start_request()`，**两个事件都触发启动**（从操作员意图看，"把开关拨到 ON"就是"开始比赛"） |
| **状态** | ✅ 已部署并真机验证（日志出现 `收到一键启动请求: EVENT,BUTTON_LED_ON`） |
| **残余风险** | 若**开机时开关已经是 ON**，固件 `Command_Init` 里 `button_stable_pressed = button_raw_pressed` 直接取当前值 → 永不产生边沿 → 不发任何事件。**现场规避：开机前确认开关在 OFF** |

### 【上位机-7】其他清理

| 子项 | 现象 | 修复 |
|---|---|---|
| 保活 ping 刷屏 | 控制台每 0.5s 一条 `[发送] ping`（2 条/秒） | `MockCommServer.client_count` 恒为 1 导致；加 `keepalive_required` 标志，Mock=False（保活本是为真实 WebSocket 维持连接）。实测 12 秒 0 条 |
| 蜂鸣器 | 本车**没有**蜂鸣器，代码是死代码 + 日志误导（`红 LED 快闪 + 蜂鸣器`） | 从 `indicator.py` 彻底移除（`buzzer_pin`、`_set_buzzer`、文案） |
| BOOT 自检"电机检查"名不副实 | 它根本不测电机，只是发 PING 探连通性 | 加 4 次重试 + 长时间超时 + 详尽注释说明它到底是什么 |

---

## 2. 新增功能：开场退避（进 AUTONOMOUS 后自动后退出场）

**需求**：现场小车**斜 45° 摆在出发区正方形的对角线上**（两差速轮靠近减速带、万向轮远离），
每次开赛都要先退一段才能进场地。做成开场动作后 → **按一次启动开关即可全自动**。

**实现**：`AutonomousState._run_startup_backup()`，在 `start_match()` 成功后、主循环开始前执行。

```yaml
# config/robot.default.yaml
match:
  startup_backup_mm_s: -300.0   # 负值=后退，0=关闭（默认关闭）
  startup_backup_s: 5.0         # 时长
```

**要点**：退避期间以 **50Hz** 持续发 `VEL`（下位机速度看门狗 300ms 保持 / 800ms 停车，发慢了会被判超时停车）；退避产生的位移由里程计自然记入，不需要额外修正。

**实测**：`🔄 开场退避：-300 mm/s × 5.0s → ✅ 开场退避完成（250 帧 VEL）` —— 车确实进了场地。

---

## 3. 新增配置：`START_HEADING_DEG`（现场声明真实车头朝向）

> **📌 后记（2026-09-17，本节之后已改进 —— 阅读时请注意）**
> 本节记的是当时的手工做法：**每换一个出发区都要人手算这个角度再填进命令**。
> 现已改为**由出发区自动推导**（朝向是区号的纯函数 = 区中心指往外侧角的方向），
> 日常启动只需 `./start.sh <区号> <颜色>`，`START_HEADING_DEG` 退化为
> "摆位不符合约定时的覆盖手段"。**取值表已扩充到 4 个区**，见 `docs/RUNBOOK.md` §1.7.1。
> 本节的实测反解仍是该约定的原始证据，故保留原文。

**为什么必须要有**：`odom_to_upper()` 拿"出发区车头朝向"旋转里程计位移，
**假设错多少度，整张地图就整体转错多少度**。而现场小车常常不是正朝场内摆的。

```bash
START_HEADING_DEG=45 ./run.sh        # 2 号区、车头朝出发区外侧角
```

**取值参考**（2 号区，起点 (2850,2850)）：

| 值 | 含义 |
|---|---|
| `-90°` | 车头正对场地内侧（-Y）—— **软件默认** |
| `-135°` | 车头朝场地中心 (1500,1500) 方向（对角线） |
| `+45°` | 车头朝出发区外侧角落 —— **此时"后退"才是朝场地中心** |

**本轮的实测反解**（用户确认车头朝外角 +45°）：

```
基线 ODOM: (0.686, 1.1093) m, θ=-1.7348 rad (-99.4°)
退避后 ODOM 增量: (+0.369, +1.513) m, 模长 1.557 m

START_HEADING_DEG=  -90.0°  →  位移 (  +117, +1553)  方向  +85.7°   ❌ 朝场外
START_HEADING_DEG= -135.0°  →  位移 ( +1181, +1015)  方向  +40.7°   ❌
START_HEADING_DEG=  +45.0°  →  位移 ( -1181, -1015)  方向 -139.3°   ✅ 朝场地中心（期望 -135°）
```

> **结论**：`+45°` 与期望方向（对角线朝场地中心 -135°）只差 `4.3°`，
> 那就是车在退避过程中慢慢偏掉的角度。**朝向判断被数据证实。**

---

## 4. 正确的启动流程（现场照做）

```bash
cd ~/rescue && TEAM_COLOR=red START_ZONE=2 START_HEADING_DEG=45 ./run.sh
```

1. 确认 **STM32 板上 `ON` 自锁开关在 OFF**
2. 启动程序 → 等 BOOT 自检通过 → 进 **DEBUG**（绿 LED 常亮）
3. **拨开关到 ON** → 进入 AUTONOMOUS
4. 日志要出现并**互相对得上**：
   ```
   main: 抽签出发区 = 2 号 → 起点 (2850.0, 2850.0, 0.785...)      ← +45°
   autonomous_state: 起点=(2850, 2850)mm，朝向=+45°                ← 必须也是 +45°
   里程计基线已记录: (...) m, θ=... rad
   底盘启动完成（PONG + ACK,START）
   🔄 开场退避：-300 mm/s × 5.0s
   ✅ 开场退避完成（250 帧 VEL）→ 转入自主导航
   ```
5. 退避后位姿应在 **(1669, 1835)** 附近，**不应出现 `A*: 起点 不可通行`**

**停车**：`Ctrl+C`。程序崩了也不怕——下位机速度看门狗 800ms 自动停。
（代码**刻意不用 `ESTOP`**：协议 §101 明确 `ESTOP` 锁板后 `START` 无法解锁，会逼着两场之间断电重启。）

---

## 5. 本次未完成 / 下次开机待验证

| # | 事项 | 说明 |
|---|---|---|
| 1 | **完整自主跑一遍** | 修好朝向后的完整流程**还没验证过**——这是下次开机第一件事 |
| 2 | 【上位机-3】两处朝向一致 | 跑起来后确认 `main` 与 `autonomous_state` 打印**同一个角度** |
| 3 | 【上位机-5】舵机 ACK 重试 | 待套取动作真机验证 |
| 4 | **`SLEEVE_ROI` 标定** | 夹爪 V2 换框后旧值大概率失效，未标定会导致"套取总是失败"。标定前建议先 `sleeve_confirm: false` |
| 5 | 直行会拐弯 | 实测直行 5 秒 Δθ 达 5.8~24°（走弧线），影响导航落点精度，原因未查 |
| 6 | 视觉误报 | 真实地面实测：绿色物体被分类成「普通物资（初赛）绿色正方体」→ 会让首趟做废（首趟必须且仅 1 个普通物资）。待加面积上限 + 形状合理性校验 |
| 7 | RDK 系统时间未对时 | 显示 2000-01-01，日志时间戳失真 |
| 8 | `run.sh` 写死 `SKIP_CAMERA_CHECK=1` | 相机坏也放行 → 感知降级 Mock → 车追假目标。现场建议去掉；**但必须先确认去掉后自检不会卡**（它当初就是为了绕开这个才写死的），改前单独跑一次 `SKIP_CAMERA_CHECK=0` 试 |
| 9 | ~~补跑 SWD `-v` 校验~~ | ✅ **已完成**（§8.1②）：改用**只读读回比对**（`objcopy` 出镜像 → `-u` 从芯片读回 → `cmp`），`37548` 字节零差异。中间一度连不上，根因是 `usbipd` 直通留下的残留状态，**拔插 USB 即恢复**；判据是 `--list` 读不到探针 FW |

---

## 6. 验证记录

| 项 | 结果 |
|---|---|
| `compileall` | ✅ |
| `tools/fix_verifiers/run_all.py` | ✅ 7/7 |
| `tools/hw_selftest.py --mock` | ✅ PASS=7 FAIL=0 SKIP=7 |
| 决策引擎自测 | ✅ exit 0 |
| 创新集成测试 | ✅ 15/15 |
| 规范仿真 `snapshot_sim.py` | ✅ **80/80/80/85/80**，`valid==delivered`，无 ERROR —— **与基线逐位一致，零回退** |
| 固件编译 | ✅ FLASH 57.29%（含自愈看门狗） |
| 真机：`start_match` ×3 | ✅ 4ms / 3536ms / 5293ms 全成功 |
| 真机：开场退避 | ✅ 250 帧 VEL，车确进场 |
| 真机：`START_HEADING_DEG` | ✅ 两处一致 +45°，反解方向 −139.3° ≈ 期望 −135° |

---

## 7. 方法论：这一轮学到的三条

1. **"看起来像硬件" ≠ 硬件问题。** 本轮 7 条上位机问题里有 5 条症状都像"接线/硬件坏"
   （串口没收数、电机检测不到、按按钮没反应、车不动）。**先找"有没有自相矛盾的日志"**，
   比拆线快得多——本轮两次都是靠"同一量打出两个不同值"定位的。

2. **静默失败最贵。** 【固件-1】IMU 失败却打死整个 MCU、【上位机-1】START 不清零却无人报错，
   都属于"错得很安静"。**该 fail-fast 的地方 fail-fast，该降级的地方明确降级**，
   别让一个支路的故障静默地拖垮全局。

3. **加接口时要全局搜索同类计算点。** 【上位机-3】就是加 `START_HEADING_DEG` 时
   漏了 `AutonomousState` 里那次重复计算。**重复的"唯一来源"就不是唯一来源。**

---

## 8. 仓库 ↔ RDK 同步核查（2026-09-17）

**核查方法**：两侧各自 `find -type f`（排除 `.git` / `__pycache__` / `*.pyc` /
`firmware/{Drivers,build}` / `.venv` / `*.log`）→ `LC_ALL=C sort` → `md5sum`，
再 `diff` 两份清单。**不是抽查，是全量逐字节**。
（`LC_ALL=C` 是必需的：默认 locale 下两侧排序规则可能不同，会造成假差异。）

**结果**：`src/ config/ tools/ scripts/ docs/ tests/ firmware/` 与根目录文档
**全部逐字节一致**，差异只有 3 处：

| # | 差异 | 判定 | 处置 |
|---|---|---|---|
| 1 | `.agent-teams/**` 仅本地有（10 个文件） | ✅ **本该如此**，是本地 AgentTeams 协作运行时状态，已被 `.gitignore` 忽略（`git ls-files` 确认 0 个入库） | 不同步 |
| 2 | `.gitignore` 仅本地有 | ⚠️ RDK 上**根本没有这个文件**（不是内容不同） | 已 rsync 过去，md5 一致 |
| 3 | **`run.sh` 仅 RDK 有** | 🔴 **真缺陷**（详见下） | 已按字节取回仓库并入库 |

### 🔴 关于 `run.sh`：文档在教人执行一个仓库里不存在的文件

`run.sh` 是**实际启动入口**（17 行：设 `RUN_MODE/CHASSIS_PORT/CAM_INDEX/PYTHONPATH` +
`exec python3 -m rescue_robot.main "$@"`），但它此前**只存在于 RDK 的 `~/rescue/` 下，
从没进过仓库**，而 `docs/RUNBOOK.md:293` 与本文档 §4 都在教人执行 `./run.sh`。

后果很直接：**任何人克隆仓库、照文档执行，第一步就 `No such file or directory`**；
而 RDK 的 SD 卡一旦损坏或换卡，这个唯一入口就永久丢失 ——
和 §3 固件那两个问题属于**同一类风险：关键资产只有一份、且在无版本控制的地方**。

已用 `scp`（**不手抄**，避免中文注释被改坏）取回并 `md5sum` 双向比对一致：
本地 `902870eea33ef4e596a29c7da5103d8c` == RDK 原件。

### 部署方式确认

RDK 上 **不是 git 仓库**（`~/rescue/` 无 `.git`），是**纯 rsync 部署**。
即：**仓库是唯一事实来源**，RDK 只是运行副本。
→ 每次改完必须：`commit` → `push` → `rsync` 到 RDK，**顺序不能反**，
否则 RDK 上的临时改动会静默覆盖掉仓库内容（这次 `run.sh` 就差点是这种情况）。

> 同步核查建议固化成习惯：**动完现场就在两侧各跑一次 md5 清单 diff**。
> 这次正是"顺手全量比一下"才发现 `run.sh` 缺失的 ——
> 它不在任何一份"已知问题清单"里，因为**没人想过要去数文件**。

### 8.1 单片机（固件）同步核查

同步的目标是：**确认 MCU 里跑的就是仓库 `firmware/` 这份源码编出来的镜像**。
分"源↔构建"和"构建↔芯片"两段，前一段已完成，后一段受阻。

#### ① 源 ↔ 构建 ✅ 通过

| 项 | 结果 |
|---|---|
| 仓库 `firmware/Core` vs Windows 构建源 `C:\...\rescue_f103c8\Core` | ✅ **28/28 个 `.c`/`.h` 逐字节一致** |
| `main.c` 源码改于 → 目标文件编译于 | 14:54:45 → **14:57:27** ✅ 晚于源码 |
| `command.c` 源码改于 → 目标文件编译于 | 15:56:06 → **15:56:12** ✅ 晚于源码 |
| `rescue_f103c8.elf` 链接于 | **15:56:13** ✅ 晚于所有源码（最新源码 15:56:06） |

→ **两处修复的目标文件都晚于各自的源码，且 elf 链接在所有源码之后**，
即这个镜像确实含修复 1（IMU 降级）与修复 2（RX 看门狗）。

**留档**：`rescue_f103c8.elf`
`md5 419cd36b70aeaa897789151dda3b1500`，`1049584` 字节，构建于 `2026-09-16 15:56:13`。

#### ② 构建 ↔ 芯片 ✅ **已通过（字节级）**

**方法：只读读回比对**（不写入、不复位），比 `-w ... -v` 更强——
它证明的是"**芯片此刻就已经是**这份镜像"，而不是"写入后被写成了这份镜像"。

```bash
# 1) 把 ELF 转成 Flash 镜像（objcopy 按 LMA 排布，即烧录内容）
arm-none-eabi-objcopy -O binary build/Debug/rescue_f103c8.elf fw_from_elf.bin   # 37548 字节
# 2) 从芯片读回同长度（-u = upload，只读）
STM32_Programmer_CLI -c port=SWD -u 0x08000000 37548 fw_from_chip.bin
# 3) 逐字节比对
cmp fw_from_elf.bin fw_from_chip.bin
```

| 项 | 值 |
|---|---|
| ELF 镜像 | `37548` 字节，`md5 d7645a16e6c6fd64277fdc3bc5a817da` |
| 芯片读回 | `37548` 字节，`md5 d7645a16e6c6fd64277fdc3bc5a817da` |
| `cmp` | ✅ **无任何差异** |

> 37548 字节 ≈ 64K 的 57.3%，与编译日志 `FLASH 57.29%` 吻合，长度也对得上。

**芯片信息**：`Device ID 0x410`（STM32F101/F102/F103 Medium-density）、
`Revision ID Rev A`、`NVM size 128 KBytes`、`Cortex-M3`。

> ⚠️ 注意 **芯片实际 NVM = 128 KB，而链接脚本 `STM32F103XX_FLASH.ld:59` 写的是
> `LENGTH = 64K`**（STM32F103C8 标称 64K，但这批片子实测 128K）。
> 当前固件只用了 57%，**没有触顶，无害**；但若将来固件涨到 64K 以上，
> 会先撞链接脚本的墙而不是片子的墙 —— 届时改 `LENGTH` 即可。

##### 曾一度连不上：原因是 usbipd 残留状态，不是接线

第一次尝试时**全部失败**，一度误判为"物理接线问题"。实际根因是：
本轮早些时候这块 ST-Link 被 `usbipd bind/attach` 直通给 WSL，
`detach` 之后 Windows 侧留下了**残留设备状态**。

**决定性判据**：`STM32_Programmer_CLI --list` 里**探针的 FW 版本是空的**，
SN 退化成了 Windows 实例路径（`5&1F94C9DB&0&6`）。
**读探针 FW 只需要 USB、完全不需要目标板** —— 它读不到，就说明
**主机↔探针这一段坏了**，与 SWD 接线无关。
而当时 `Get-PnpDevice` 显示 `Status OK`、`ProblemCode=0`、WinUSB 驱动正常、
无进程占用、`usbipd list` 还显示 `Not shared` —— **这些"看起来正常"的指标全都无法证伪它**。

**解决**：拔掉 ST-Link USB、等几秒重插，立刻恢复：

| | 修复前 | 重插后 |
|---|---|---|
| `ST-LINK SN` | `5&1F94C9DB&0&6`（Windows 实例路径，假的） | `37FF71064E573436439E1943`（真实 SN） |
| `ST-LINK FW` | **（空）** | `V2J37S7` |
| `Access Port Number` | `0` | `1` |
| 连接目标 | `DEV_CONNECT_ERR` | `Voltage 3.29V`、`Device ID 0x410` |

> **教训（可复用的诊断法）**：
> 1. **`--list` 的 `ST-LINK FW` 是否为空，是"主机↔探针"与"探针↔目标"的分界判据。**
>    FW 读不出来 → 先查主机侧（重插换口、usbipd 残留、过滤驱动），**别去拆 SWD 线**；
>    FW 读得出来但连不上目标 → 才轮到查接线（SWD 座 / 共地 / CLK-DIO 反接 / VTref / NRST）。
> 2. **`Get-PnpDevice` 的 `Status OK` 不等于设备可用。** 设备能枚举、驱动正常、
>    `ProblemCode=0`，工具照样可能一句话都跟它说不通 —— **要用"工具能不能读到它的 FW"来判**。
> 3. **`usbipd` 的副作用会延续到 `detach` 之后。** 用过直通就**拔插一次**再做烧录，
>    比逐个排查驱动栈快得多。

##### 备查：当时排除过的项（供下次快速定位）

| 排查项 | 证据 | 结论 |
|---|---|---|
| 是否被 usbipd 劫持 | `usbipd list` → **Not shared**；WSL `lsusb` 看不到它 | ⚠️ **显示正常但仍有残留状态**，不可作为判据 |
| 驱动是否正确 | Service=`WinUSB`，Provider=STMicroelectronics，**ProblemCode=0** | 正常（但不足以说明能用） |
| 探针固件是否活着 | `ST-LINK_gdbserver` 报 `Error in initializing ST-LINK device` | ⚠️ 当时被误读为"探针健康" |
| 目标 MCU 是否有电 | RDK 3 秒收到 **400 字节**遥测（ODOM/TEL 正常刷） | ✅ 有电在跑（这条是真的，排除了供电） |
| 固件是否禁用了 SWD | `stm32f1xx_hal_msp.c:79` 只有 `__HAL_AFIO_REMAP_SWJ_NOJTAG()` = **只关 JTAG、保留 SWD** | ✅ 未禁用（这条也是真的） |

失败时试过的组合：`mode` = 默认 / `UR` / `hotplug`、`freq=100`、
`ST-LINK_gdbserver -m 0 / -m 1` —— 一律 `DEV_CONNECT_ERR`。
**这些全都改变不了"主机读不到探针 FW"这个事实，所以全都没用。**
真正的物理接线问题其实**从未被证实**（重新插拔 USB 后一次就连上了）。

#### ③ 行为侧旁证（非字节级，但方向一致）

修复 2 有一个可观测签名：**接收死窗口**。修复前固件在约 18 次探测内必现 ≥6 秒
完全无响应；修复后理论上限 ≤ 约 600ms（看门狗周期 500ms + 1 字节）。

实测（RDK 直连 `/dev/ttyS1`，每 100ms 发一次 `PING`，持续 60 秒）：

| 指标 | 实测 | 修复前固件 |
|---|---|---|
| 发出 PING / 收到 PONG | **546 / 546（100.0%）** | 18 次里成功 7 次 |
| 相邻 PONG 最长间隔 | **120ms**（恰好一个发送周期） | ≥ 6000ms |
| 间隔 > 1s 的次数 | **0** | — |
| 间隔 > 6s 的次数 | **0** | 必现 |

→ 546 次连续探测零长间隔，与"运行中的镜像已带 RX 看门狗"一致。
**但这只是旁证**：它证明"没有出现旧固件的故障签名"，不等于"字节与仓库相同"。

> 注：本条旁证是在 ② 受阻期间做的"不空等"动作。之后 ② 做成了**字节级**校验并**完全通过**，
> 所以本条的定位从"主要证据"降为"**独立第二来源**"——它从**行为**上佐证，
> 与 ② 从**字节**上证明，两条互相独立且结论一致，比任何单一条都更稳。
> 这类"一个结论用两条不相干的路径各验一次"的做法值得保留。

**结论**：上位机侧同步 ✅ 完成（§8 全量 md5 清单 diff，非协作产物零差异）；
固件侧"源↔构建"✅ 完成（§8.1① 28/28 逐字节一致）；
"构建↔芯片"✅ **完成**（§8.1② 只读读回比对，`37548` 字节 `cmp` 无差异）。

**即：仓库、RDK、MCU 三者现在是一致的。**

### 8.2 同步过程中的一次操作失误（留档，避免重犯）

本次同步时把命令写成 `rsync -az --delete docs rdk:~/rescue/docs/` ——
**源目录末尾漏了 `/`**。rsync 的语义是：

| 写法 | 含义 |
|---|---|
| `rsync -a SRC/ DST/` | 把 SRC 的**内容**同步进 DST ✅ 想要的效果 |
| `rsync -a SRC  DST/` | 把 SRC **这个目录本身**放进 DST → 变成 `DST/SRC/` ❌ 嵌套 |

结果：在 RDK 上生成了嵌套的 `~/rescue/docs/docs/`（内容其实是新的、md5 与本地一致），
而**顶层那份 `~/rescue/docs/` 没有被更新** —— 表现为"同步命令成功退出，但文件没变"。

**这次没造成损失**，但同一写法配上 `--delete` 是能真删文件的，属于高危操作。
已处置：删除嵌套目录、并用 `rsync -az --delete docs/ rdk:~/rescue/docs/`
（源带 `/`）重同步，md5 复核为 `bd4df190ae59` 两侧一致。

> **教训**：`rsync` 加了 `--delete` 之后，**源和目标两端的尾斜杠必须当成语法来读**，
> 不能靠"看起来对"。而且它**成功退出的退出码不能证明同步对了** ——
> 唯一可靠的验收还是回归到 **两侧 md5 清单 diff**（正是本节开头那个方法）。
> 这也是为什么本节坚持"全量比对"而不是"看 rsync 有没有报错"。
