Tony-Stank-shift/Rescue-team/firmware/Core/Src/main.c

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
/* Includes ------------------------------------------------------------------*/
#include "main.h"

/* USER CODE BEGIN Includes */
#include "command.h"
#include "encoder.h"
#include "motor.h"
#include "mpu6050.h"
#include "odometry.h"
#include "servo.h"
#include "speed_control.h"
#include "telemetry.h"

/* USER CODE END Includes */

I2C_HandleTypeDef hi2c2;

TIM_HandleTypeDef htim1;
TIM_HandleTypeDef htim2;
TIM_HandleTypeDef htim3;
TIM_HandleTypeDef htim4;

UART_HandleTypeDef huart1;

void SystemClock_Config(void);
static void MX_GPIO_Init(void);
static void MX_I2C2_Init(void);
static void MX_TIM1_Init(void);
static void MX_TIM2_Init(void);
static void MX_TIM3_Init(void);
static void MX_TIM4_Init(void);
static void MX_USART1_UART_Init(void);
/**
  * @brief  The application entry point.
  * @retval int
  */
int main(void)
{

  /* MCU Configuration--------------------------------------------------------*/

  /* Reset of all peripherals, Initializes the Flash interface and the Systick. */
  HAL_Init();

  /* Configure the system clock */
  SystemClock_Config();

  /* Initialize all configured peripherals */
  MX_GPIO_Init();
  MX_I2C2_Init();
  MX_TIM1_Init();
  MX_TIM2_Init();
  MX_TIM3_Init();
  MX_TIM4_Init();
  MX_USART1_UART_Init();
  /* USER CODE BEGIN 2 */

  /* PWM 启动后仍保持 MOTOR_STBY=0，直到 START 或实体按钮解锁。 */
  if (Motor_Init(&htim1) != HAL_OK)
  {
    Error_Handler();
  }

  if (Encoder_Init(&htim2, &htim3) != HAL_OK)
  {
    Error_Handler();
  }

  if (Servo_Init(&htim4) != HAL_OK)
  {
    Error_Handler();
  }

  /*
   * IMU(MPU6050) 故障**不得**拖垮整条链路 —— 这里刻意不调用 Error_Handler()。
   *
   * 原因（2026-09-16 现场实际踩到，排查耗时数小时）：
   *   Error_Handler() 是 `__disable_irq(); while(1){}` 的**永久死循环**，
   *   而 Telemetry_Init() 排在 MPU6050_Init() **之后**。于是只要 IMU 没接上 /
   *   没供电 / 虚焊 / SCL·SDA 接错 / WHO_AM_I 不为 0x68，
   *   固件就会在初始化阶段卡死，**遥测一个字节都不发**。
   *   上位机侧表现为"串口能打开但完全无数据"，极易被误判为
   *   RDK 串口故障或接线问题，实际是 IMU 支路把整个 MCU 拖死。
   *
   * 降级行为（各下游本来就已做好守卫，故安全）：
   *   - MPU6050_Update() 有 `if (!initialized) return HAL_ERROR;`
   *   - MPU6050_GetLatestSample() 在 sample_valid=false 时返回 false
   *   - Telemetry_Update() 的 IMU 段仅在 GetLatestSample 为真时才发，
   *     IMU 行自动跳过；ODOM / TEL 以及命令交互照常工作。
   *   即：没有 IMU 时定位用纯里程计（少了陀螺仪修正），但机器人不再变砖。
   *
   * 其他初始化（Motor/Encoder/Servo/Command）只检查静态定时器指针与 HAL 返回值，
   * 现实中不会失败，故仍保留 Error_Handler() 作为真正的致命保护。
   * IMU 状态可用 MPU6050_GetLastStatus() 查询（HAL_OK=正常，其余=故障）。
   */
  (void)MPU6050_Init(&hi2c2);

  SpeedControl_Init();
  Odometry_Init();
  Telemetry_Init(&huart1);

  if (Command_Init(&huart1) != HAL_OK)
  {
    Error_Handler();
  }

  /* USER CODE END 2 */

  /* Infinite loop */
  /* USER CODE BEGIN WHILE */
  while (1)
  {
    /* USER CODE END WHILE */

    /* USER CODE BEGIN 3 */
    Command_Update();

    /* IMU 未就绪时周期性重试初始化。
       启动时那次 MPU6050_Init 已改为非致命（不会 Error_Handler 死循环），
       但若就此不重试，开机瞬间没应答就会**整场没有 IMU 帧**
       （2026-09-17 实测：串口只剩 ODOM/TEL，上位机自检报 IMU 失败）。
       本调用失败时每 1s 重试一次，成功后自动转为正常，开销可忽略。 */
    MPU6050_TaskRetryInit(&hi2c2);

    (void)MPU6050_Update();

    if (Encoder_Update())
    {
      Odometry_Update(
          Encoder_GetLeftDelta(),
          Encoder_GetRightDelta(),
          Encoder_GetSamplePeriodSeconds());

      SpeedControl_Update(
          Encoder_GetLeftRpm(),
          Encoder_GetRightRpm(),
          Encoder_GetSamplePeriodSeconds());
    }

    Telemetry_Update(
        (int16_t)SpeedControl_GetLeftTargetRpm(),
        SpeedControl_GetLeftMeasuredRpm(),
        (int16_t)SpeedControl_GetRightTargetRpm(),
        SpeedControl_GetRightMeasuredRpm(),
        Motor_GetLeftCommand(),
        Motor_GetRightCommand());
  }
  /* USER CODE END 3 */
}

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
/* USER CODE BEGIN 4 */

void HAL_GPIO_EXTI_Callback(uint16_t GPIO_Pin)
{
  if (GPIO_Pin == MPU6050_INT_Pin)
  {
    MPU6050_NotifyDataReadyFromIsr();
  }
}

/* USER CODE END 4 */
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
