Tony-Stank-shift/Rescue-team/firmware/Core/Inc/chassis_config.h

#ifndef CHASSIS_CONFIG_H
#define CHASSIS_CONFIG_H

/* 底盘机械参数统一放在这里，标定时只需要修改这一处。 */
#define CHASSIS_WHEEL_DIAMETER_MM            65.0f
#define CHASSIS_TRACK_WIDTH_MM              209.0f
#define CHASSIS_ENCODER_COUNTS_PER_WHEEL_REV 68028.0f

#endif /* CHASSIS_CONFIG_H */
