Tony-Stank-shift/Rescue-team/(commit log)

2026-08-07 docs: 添加智能救援赛项完整 README（基于官方赛题与评分规则）
2026-08-07 docs: 添加软件任务清单 MEMORY.md（覆盖感知/导航/决策/控制/对抗/通信/测试）
2026-08-07 feat: 实现板块0——核心状态机+一键启动+系统自检
    - state_machine.py: BOOT→DEBUG→AUTONOMOUS 三态状态机，on_exit/on_enter 锁外执行，AUTONOMOUS 不可逆
    - boot_state.py: 上电自检（8项），通过自动转DEBUG，失败转ERROR
    - debug_state.py: 等待一键启动按钮（长按500ms确认），允许笔记本通信
    - autonomous_state.py: 全自主主循环(50Hz)，15秒看门狗，外部输入锁定
    - button.py: GPIO按钮抽象（Mock+真实），50ms防抖，长按/短按区分
    - indicator.py: LED+蜂鸣器状态指示（慢闪/常亮/快闪/红色报警）
    - system_check.py: 传感器+电机+电源三项自检，含Mock
    - config.py: 全局时序/引脚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
2026-08-07 feat: 实现板块1——感知模块（检测+分类+世界地图+对方跟踪+传感器融合）
    - target_types.py: 目标枚举/初赛4类/决赛4类配置表（与README完全一致）
    - detection.py: AbstractDetector + CVDetector(HSV颜色分割+形状分析) + MockDetector
    - classification.py: 颜色+形状→目标类型分类器，含颜色容差匹配，支持初赛/决赛切换
    - world_map.py: 动态世界地图，最近邻目标关联，增删查改，按类型/距离/分值查询
    - field_elements.py: 3000x3000标准场地23元素（出发区x4/安全区红蓝/减速带x12/围栏）
    - opponent_tracker.py: 对方机器人跟踪/轨迹预测/接触检测/10秒计时预警
    - sensor_f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
2026-08-07 feat: 实现板块2——自主导航模块（定位+路径规划+运动控制+禁区管理）
    - localization.py: Mock/Odometry定位器，里程计+IMU融合，强制分离重定位
    - path_planner.py: 60x60网格CostMap，A*全局规划，DWA局部避障
    - motion_control.py: PID级联控制(距离+角度)，连续过渡(角度大减速)，越障模式
    - forbidden_zones.py: 对方安全区/场地边界禁区管理，预警+违规检测
    - navigation_pipeline.py: 主导航管线update()→VelocityCommand，对接autonomous_state
    - 修复: 角速度PID符号反、网格离散误差导致震荡、过渡改为连续而非硬切换
2026-08-07 feat: 实现板块3——转运控制模块（夹爪+装载规则+投放判定）
    - gripper.py: 夹爪控制（Mock+舵机），支持夹取/保持/释放
    - load_manager.py: 装载管理器+规则引擎，5种违规检测
    - safe_zone_placer.py: 投放分区判定（物资区/伤员区/围栏/区外），扣分逻辑
    - transport_pipeline.py: 转运主控（接近→夹取→运送→投放），6项测试全部通过
    - 关键规则: 首次=1普通物资, ≤3个, 伤员单独, 危险禁止, 投放错区=-10分
2026-08-07 feat: 实现板块4——决策与状态机（FIRST_TRIP→FREE_RUN+异常检测）
    - decision_engine.py: 比赛策略状态机, FIRST_TRIP→FREE_RUN→TIME_PRESSURE/DONE
    - target_selector.py: 目标评分(分值+距离+时间+对手因子), 伤员15>核心10>普通5
    - anomaly_handler.py: 15s看门狗/失控检测/传感器降级/卡死脱困
    - Action输出: NAVIGATE_TO/GRIP/TRANSPORT_TO/RELEASE/RECOVER/EMERGENCY_STOP
    - 6项测试全部通过(首次转运/状态转移/优先级/异常检测)
2026-08-07 fix: 修复核验发现的7个缺失项+1个导出
    板块1: DetectedTarget+orientation, Detection+orientation, CVDetector轮廓PCA朝向估算, 新建field_detector.py
    板块2: VisualSLAMLocalizer桩, OdometryLocalizer定位置信度恢复
    板块3: transport接近策略(距离递减+伤员侧面), gripper.close_with_retry(max=3)
    板块4: decision无效转运恢复(检测场地中央500mm内目标)
    其他: perception/__init__.py导出field_detector
    [transport_pipeline.py]
2026-08-07 feat: 实现板块5——对抗策略模块
    - opponent_strategy.py: 威胁评估(LOW/MEDIUM/HIGH/CRITICAL)
    - 10秒脱离策略(>7s预警后退,>9s强制脱离)
    - 目标争夺决策(距离+分值+对方行为,抢先vs放弃)
    - 对方阻挡→绕行(不推撞), 进攻→避让(不反击)
    - 对方送分→不干扰(白得分)
    - 10项测试全部通过
2026-08-08 feat: 15秒防停淘汰——四层降级保活系统
    核心变更: 机器人永远不能停, 遇问题逐级降级而非停止等待。
    降级链 (Level 0→4):
    L0 正常工作 → L1 重试(3次) → L2 换目标 → L3 探索扫描 → L4 保命绕圈
    涉及文件:
    - decision_engine.py: FallbackLevel(0-4)+_get_explore_target+_get_survival_target
    - anomaly_handler.py: 分级看门狗(10s/13s/15s), NO_ACTION_15S改为fatal=False
    - navigation_pipeline.py: explore()+survival_circle()
    - autonomous_state.py: 10s→探索预警, 13s→保命预警, 15s→最后防线
    - MEMORY.md: 新增4.5节四层降级保活链, 更新4.4节+附录B
    关键变化: 15s无动作不再淘汰→改为降级保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
2026-08-10 feat: 实现板块6——通信模块（DEBUG双向+AUTONOMOUS单向）
    - comm_protocol.py: JSON消息协议,8种消息类型,BLOCKED_IN_AUTONOMOUS安全列表
    - comm_server.py: MockCommServer(控制台)+WebSocketServer(真实桩)
    - comm_manager.py: 模式感知通信, AUTONOMOUS拦截CONFIG_SET/COMMAND, DEBUG双向
    - 7项测试全部通过(状态广播/配置读写/拦截/写保护/模式切换)
2026-08-10 feat: 实现板块8 系统健壮性 (fault_tolerance + stability + logging_system)
    - fault_tolerance.py: SensorHealthMonitor 传感器降级监控, MotorFaultDetector 电机故障检测(堵转/空转/过热), CommWatchdog 通信中断恢复, PowerMonitor 电源分级告警
    - stability.py: MatchStabilityTracker 多场稳定性追踪, MemoryMonitor 内存泄漏检测(线性回归), BootSuccessTracker 启动成功率(≥99%)
    - logging_system.py: StructuredLogger JSON行格式日志, EventRecorder 30+事件类型记录, LogStorage 目录管理+轮转+清理
    21项单元测试 + 9项集成测试 + 9项边界测试 全部通过
    [fault_tolerance.py, logging_system.py, stability.py]
2026-08-10 feat(innovation): 完成板块7 创新实践适配 — 3轮自检全部通过
    实现 7 项决赛现场编程支撑功能 (7.1 + 7.2):
    **7.1 模块化与可配置性:**
    - config_loader.py: YAML/JSON 参数化配置系统 (ConfigLoader + RobotConfig + FieldConfig + schema 验证)
    - model_switcher.py: 初赛/决赛模型一键切换 (CompetitionPhase + 配置指纹验证)
    - hardware_profile.py: 硬件抽象层扩展 (HardwareProfile + CalibrationRoutine + ComponentAdapter)
    - hot_reloader.py: 策略参数热更新 (mtime 轮询 + callback + AUTONOMOUS 锁定)
    **7.2 现场编程效率:**
    - deploy.py: 快速部署流水线 (< 5min: 依赖检查 → 冒烟测试 → 代码同步 → 远程重启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
    [robot.default.yaml]
2026-08-10 feat(simulation): add MuJoCo 3D simulation (Section 9)
    - 11 simulation modules: sim_world, sim_field, sim_robot, sim_target,
    sim_opponent, sim_sensors, sim_scenario, sim_runner, sim_debug_gui,
    sim_models, __init__
    - MuJoCo 3.11.0 physics engine with 250Hz timestep
    - 3000x3000mm competition field (safe zones, start zones, speed bumps, fences)
    - Differential drive robot with pusher mechanism
    - 6 target shapes (cube, pyramid, cuboid, cylinder, cone_frustum, sphere)
    - 3 opponent AI behaviors (random, competitive, aggressive)
    - Sensor simulation: camera (FOV 90°), IMU, odometry with noise
    - 6 preset scenarios via sim_scenario
    - 30 tests (15 unit + 8 integration + 7 edge cases) all passing
    -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
2026-08-11 feat: 2D visualization simulation with 4-view HTML viewer
    - sim_2d.py: Pure Python 2D simulation engine with differential drive
    kinematics, carry/deliver mechanics, hardware state simulation
    (motors, IMU, encoders, battery, ultrasonic, odometry drift)
    - build_2d_viewer.py: Generates self-contained HTML with embedded
    simulation data, no external dependencies
    - 4 interactive tabbed views:
    1. Competition Scene: animated 2D field with robot + targets
    2. Software Architecture: module dependency graph + state machine
    3. Hardware System: wiring diagram with interface protocol labels
    4. Mechanical Structure: three-view drawing with dimensions
2026-08-15 根据确认的硬件信息更新 main
    - 驱动: 2 差速电机 + 1 万向轮(非驱动), 电机槽位 left/right
    - 运输机构: 套取机构(单自由度丝杆升降), gripper 重命名为 sleeve_lift
    - 轮距 192mm(两轮中心线距离)
    - 电流语义: 3-4A 为正常行驶电流, 堵转电流待定(占位 5000mA)
    - 电机型号/传感器/引脚分配均标记为待定
    [robot.default.yaml]
2026-08-28 fix: 修复决策引擎状态机与转运管线的阻塞 bug
    - decision_engine: 修正 grip_done 后 nav_arrived 分支，避免与 TRANSPORT_TO 振荡；补 import random
    - transport_pipeline: 修正 _distance 调用参数；投放触发改为到达投放点判定
    [transport_pipeline.py]
2026-08-28 feat: 集成仿真引擎，接入决策/导航/转运/感知程序
    - 新增 integrated_sim.py：统一 mm 单位，编排 DecisionEngine+NavigationPipeline+TransportPipeline+WorldMap
    - 重写 build_2d_viewer.py：数据层改用集成仿真，导出 2D 俯视图动画
2026-08-28 feat: 接线四大管线并解决不依赖硬件的软件问题
    - autonomous_state: 重写主循环，接入 PerceptionPipeline+DecisionEngine+NavigationPipeline+TransportPipeline
    - autonomous_state: 看门狗改为分级保活(10s探索/13s保命/15s不淘汰)
    - main: 创建并注入四大管线+CommManager，启动时加载 YAML 配置
    - navigation: 增加接近段直接精确接近，修复 40-80mm 卡死
    - decision: FREE_RUN 支持多目标同趟(伤员单独/普通+核心混合≤3)
    - config: 新增 apply_robot_config 从 YAML 覆盖时序/阈值
    - detection: 修复 MockDetector 坐标，使 Mock 模式目标不超界
    [config.py, main.py]
2026-08-28 docs: 待定硬件依赖清单 + 2D 集成仿真可视化产物
2026-08-29 chore: 落地已确定的硬件参数（主控RDK/电机轮距减速比/摄像头选型）
    - sim_2d: 轮距182/减速比34，编码器线数标注由底盘层负责
    - motion_control/config_loader/robot.default.yaml: wheel_base_mm 182
    - config: Pin 注释改为 RDK（非树莓派 GPIO）
    - HARDWARE_DEPENDENCIES: 更新主控RDK、摄像头选型、上下层接口待办
    [robot.default.yaml]
2026-08-29 feat: 新增下位机接口适配层 ChassisInterface
    - 坐标/单位转换：下位机里程计(m,rad,x向前y向左) → 上层(mm,rad,x向右y向前)
    - 速度命令格式化：VEL,v_mm_s,w_mrad_s
    - START 启动命令 + 初始偏移管理
    - HARDWARE_DEPENDENCIES: 记录完整上下行接口协议
2026-08-29 feat: 新增串口底盘驱动 SerialChassis（上位机↔STM32）
    - serial_chassis: 收发 VEL/START 命令，解析 ODOM 下行帧，坐标转换
    - HARDWARE_DEPENDENCIES: 记录 STM32 USART1 引脚、底盘引脚、调试链路
2026-08-29 chore: 轮距更新为209mm + 摄像头标记已购买
    - 轮距 182→209（两驱动轮中心线），同步 sim_2d/motion_control/config_loader/hardware_profile/robot.default.yaml/测试断言
    - HARDWARE_DEPENDENCIES: 摄像头标记已购买
    [robot.default.yaml]
2026-08-31 feat: 串口协议严格对齐 + 底盘参数更新
    - serial_chassis: parse_frame 严格要求 ODOM 8 字段；补 PING/STOP/ESTOP + start_match 启动流程
    - sim_2d: 编码器每轮 68028、最大轮速 250RPM + 等比限幅
    - 新增 chassis_serial_protocol.md（下位机串口协议 v1）
    - HARDWARE_DEPENDENCIES: 通信协议更新
2026-09-06 feat: 摄像头/舵机/IMU 硬件参数落地 + 新增 SG90 舵机套取机构
    - 摄像头: 800W 77° 自动对焦，安装高度 21cm（camera_height_mm 210）
    - sleeve_lift: 新增 ServoSleeveLift（SG90 0~90°，夹爪 90mm）
    - HARDWARE_DEPENDENCIES: 更新摄像头/舵机/IMU（确认接 STM32）
2026-09-06 chore: 上位机最大速度对齐下位机 + 主控方案更新
    - 最大线速度 1000→850 mm/s（对齐下位机 250RPM 限值）：motion_control/path_planner/sim_2d/config_loader/hardware_profile/robot.default.yaml
    - HARDWARE_DEPENDENCIES: 主控改为电脑上位机联调（RDK 后置）
    [robot.default.yaml]
2026-09-07 feat: 将 SerialChassis 串口驱动接入自主主循环
    - autonomous_state: 新增 chassis 参数；位姿从串口读(ODOM)，速度经串口下发(VEL)；on_enter 自动 PING→START 启动底盘
    - main: REAL 模式自动创建 SerialChassis(port 可配置 CHASSIS_PORT)
2026-09-08 feat: 视觉 HSV 标定调优 + 下位机 MCU 更正为 STM32F103
    - detection.py: 四色 HSV 阈值按摄像头实测调优（绿/黑/橘/浅蓝）
    - tools/vision_calibration.py: 新增摄像头标定工具（HSV 分割 + 鼠标取色）
    - chassis_serial_protocol/serial_chassis/HARDWARE_DEPENDENCIES: STM32F407 → STM32F103（Rescue-F103）
2026-09-08 feat: 协议 v1.1 适配（舵机走串口SERVO + IMU遥测融合 + MCU更正F103）
    - serial_chassis: 支持 IMU 帧解析 + SERVO 命令发送 + read_frame 区分帧类型
    - sleeve_lift: 新增 SerialServoLift（经串口 SERVO 命令控舵机）
    - 新增 imu_fusion: IMU 零偏校准 + yaw 角速度校正
    - main: 真机 transport 用串口舵机
    - 文档: MCU F407→F103(F103C8)
2026-09-08 feat: 新增视觉测试脚本（vision_quick 自包含 + vision_test 集成版）
2026-09-08 feat: 场地重做(按PDF图7) + 感知接真实摄像头帧
    场地重做（安全区红顶/蓝底正中间 600x300 + 紫边30 + 分区300x300 + 减速带300x60/间隔50）：
    - field_elements: 安全区 x1200-1800 红顶蓝底、区内300高、紫边30、出发区1-4、减速带两条内边各3根
    - decision: 安全区投放坐标更新(1350/1650, 2820/180)
    - integrated_sim: 出发区初始朝向场地中心、目标避让新布局
    - transport: 投放判定收紧<80(窄安全区投放准)
    - viewer/config: 场景绘制与配置同步
    感知接真实摄像头帧：
    - autonomous_state: 新增 camera 参数，真机读帧→CVDetector，否则 frame=None(Mock)
2026-09-08 feat: RealHardwareChecker 框架 + 核心单测 + 协议补一键启动
    - system_check: 新增 RealHardwareChecker(摄像头/IMU/电机/电池接口, 真机后补读)
    - main: REAL 模式用 RealHardwareChecker + 注入串口底盘
    - serial_chassis: 加 wait_for_button/read_button(BUTTON,ON 一键启动)
    - chassis_serial_protocol: 补 5.1.1 一键启动按钮事件 BUTTON,ON
    - localization/comm_server/sim_2d: 标注退役/过时/废弃
    - tests/test_core_units: 新增核心单测 12 项(坐标转换/串口解析/分类/场地/自检)
2026-09-08 feat: 场地放置区隔板20居中(分区290) + 放置改推+上调
    - field_elements: 安全区中间隔板20宽居中, 分区290
    - decision: 投放坐标更新(1345/1655)
    - sleeve_lift: ServoSleeveLift/SerialServoLift 加 place_ramp(推+上调跨斜坡, RAMP_ANGLE=34°)
    - transport: 放置阶段优先 place_ramp(无则 raise_up)
    - test_core_units: 分区断言更新290
2026-09-08 feat: 放置改分步推+上调（跨紫边斜坡）
    - transport __init__: 加 place_steps/push_dist_mm 放置参数(真机标定占位)
    - PLACING 阶段: 首次设 nav 推入点(仅真机机构), 每帧 nav 前推+舵机渐进上调(90→0)
    - 仅真机机构(有 set_angle/send_servo_angle)分步; Mock/仿真一次释放, 不影响集成仿真/测试
2026-09-08 feat: 引脚按同学确认修正 + 删旧丝杆 + 一键启动触发 + 评分优化
    - config.py: START_BTN=PB9, MPU6050 INT=PB5/SCL=PB10/SDA=PB11(I2C2); 下位机引脚参考
    - HARDWARE_DEPENDENCIES: MPU6050 接线改 I2C2(PB10/PB11)
    - sleeve_lift: 删除 ScrewSleeveLift(旧丝杆,未用); __init__ 更新导出
    - main.py: REAL 用 MockButton/MockIndicator(按钮/灯在下位机), DEBUG 轮询 BUTTON,ON→one_key_start
    - target_selector: select_best 评分 points^1.3(避免远高分被近低分压过)
    [config.py, main.py, sleeve_lift.py]
2026-09-09 chore: 删除 2D/3D 仿真 + 归档散文件到 docs/
    - 删除 build_2d_viewer.py / rescue_sim_2d.html（2D 仿真）；之前已删 3D 仿真
    - 归档 docs/scene/(正确场景图 v2+diagram+PDF参考) / docs/hardware/(EDA 引脚图) / docs/vision/(视觉标定照)
    - 保留 tools/ 视觉脚本(vision_calibration/quick/test)
2026-09-14 chore: 夹爪舵机角度范围 0~90° → 0~70°（同学确认）
    - sleeve_lift: ServoSleeveLift.ANGLE_LOWERED_DEG=70, SerialServoLift 加 ANGLE_LOWERED_DEG=70
    - place_ramp/分步放置: 90→0 改 70→0（ServoSleeveLift/SerialServoLift/transport）
    - HARDWARE_DEPENDENCIES + 协议文档: 注明套取机构实际行程 0~70°（舵机物理仍 0~180）
2026-09-14 fix: 对齐下位机固件（按钮事件 + 舵机角度语义）
    按同学 rescue_f103c8 下位机仓库对齐：
    - 一键启动事件: BUTTON,ON → EVENT,START_BUTTON（serial_chassis wait_for_button/read_button；main 轮询）
    - 舵机角度语义反转: RAISED=70°(抬起/释放) / LOWERED=0°(下压套住)
    - ServoSleeveLift / SerialServoLift 常量 + place_ramp 方向(0→70)
    - transport 分步放置 deg = frac*70
    - 文档同步: 协议 BUTTON 节 / 舵机节、HARDWARE_DEPENDENCIES、config 引脚注释
    [config.py, main.py, serial_chassis.py, sleeve_lift.py, transport_pipeline.py]
2026-09-14 fix: 真机联调暴露的 3 个致命 bug（串口打开/自检）
    RDK + F103 真机部署时暴露：
    - main.py 从未调用 chassis.open() → is_open=False，自检 IMU/电机 必然失败，
    AUTONOMOUS 也无法下发 VEL。改为创建后立即 open() 并检查结果/打日志。
    - SerialChassis.send_ping() 只返回写入成功、未校验 PONG → 连通性误判。改为发 PING 后等 PONG。
    - SerialChassis.read_imu() 只读一行，而串口是 IMU/ODOM/TEL 混流 → 大概率命中 ODOM
    误判无 IMU。改为按超时循环直到拿到 IMU 帧。
    - system_check: 未接电压传感器返回 -1 直接判 FAIL 卡住启动 → 视为未知跳过；
    新增 SKIP_CAMERA_CHECK=1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
    [main.py, serial_chassis.py, system_check.py]
2026-09-15 fix: 摄像头阻塞主循环 + 套取失败不再直接放弃整趟
    问题一：摄像头启动/掉线时主循环被卡死（同学真机发现）
    - 旧实现直接在 50Hz 主循环调 cv2.VideoCapture.read() → 无帧时阻塞整个循环
    - CVDetector.detect(None) 对 None 调 cv2.cvtColor 抛异常 → 该轮 _run_once 被跳过，
    决策/导航/转运全不执行（表现为原地去世）
    - 新增 hardware/camera_reader.py：后台采集线程只留最新帧，主循环 get_frame()
    非阻塞取帧；连续读失败自动重连；支持预热等首帧
    - main.py 改用 CameraReader（+CAM_WARMUP_S 预热，超时降级 Mock）
    - autonomous_state 用 get_frame()（兼容裸 VideoCap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
    [camera_reader.py, main.py, transport_pipeline.py]
2026-09-15 fix: 视觉测距改为地平面法（底边+倾角）+ 修复假检测框
    问题（同学指出 + 代码核实）：
    - 旧 estimate_position 用面积法（sqrt(contour_area)、known_size_mm 硬编码 40mm、无倾角），
    而目标形状不同（正方体/三棱锥/长方体/圆柱）同距离下面积差异巨大 → 距离不可用
    - 更严重：perception_pipeline 调用时传的是硬编码假框 Detection(bbox=(0,0,30,30))，
    导致 center_pixel=(15,15)、contour_area=0 → 距离恒为兜底 500mm，视觉定位形同虚设
    修复：
    - CVDetector.estimate_ground_position()：底边 + 相机倾角的地平面测距
    f = W/(2·tan(FOV/2)); α = TILT + atan((y_bottom−H/2)/f);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
    [config.py, main.py, system_check.py]
2026-09-15 feat: 套取流程修复（视觉确认套取 + 显式停车 + 目标确认过滤）
    背景：逐环节审查套取链路（决策→导航→套取→装载→投放），发现 5 个问题，本车无硬件套住传感器。
    1) 套取无物理判据（真机 lower() 只要传了目标就返回 True）→ 改用【摄像头确认】
    - PerceptionPipeline.check_sleeve_occupied()：检测框中心落在归一化 SLEEVE_ROI 内
    - config.Camera.SLEEVE_ROI / SLEEVE_CONFIRM（⚠️ROI 需真机标定）
    - TransportPipeline.set_sleeve_confirm()：确认失败 → 判套取失败 → 抬爪后退重试
    - 失效保护：连续 5 次确认失败自动关闭视觉确认（防 ROI 未标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
    [config.py, transport_pipeline.py]
2026-09-15 docs(audit): 智能救援赛项要求合规审计（逐条对照 + 不符合项清单）
2026-09-15 docs(audit): 补「软件负责人视角硬约束」+「写了但没用配置清单」+「待现场公布项」(B24)
2026-09-15 docs(audit): blocker/high 项在当前代码下的复核（COMPLIANCE_AUDIT_REFRESH.md）
2026-09-15 fix: 修复审计 blocker——出发区坐标系/终场停车/多目标假装载/识别误判/保活链
    来源：AgentTeams 全项目审计（COMPLIANCE_AUDIT.md 23 项 + CODE_AUDIT.md 6 blocker/12 high）。
    本次修掉"会丢分 / 会卡死"的项，其余记入 docs/audit/FIXES.md 未修复清单。
    blocker：
    - B1 出发区坐标系写死 3 号区 → StandardFieldLayout.get_start_pose() 作唯一来源，
    START_ZONE 环境变量抽签（1~4，默认 3，非法回退并告警），on_enter 同时下发
    下位机里程计 / 导航定位器 / 状态内部位姿三处；串口默认端口改 /dev/ttyS1。
    - S-40 一趟"假装抓到全部"：旧实现车只到第 1 个目标就把本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
    [robot.default.yaml]
2026-09-15 feat(selftest): 分模块实机自检程序——现场一眼定位"哪个模块坏了"
    现场需求：真机出问题时必须立刻知道坏在哪个模块，而不是从头翻日志。
    `tools/hw_selftest.py` 按**模块**逐项检测，13 个模块各自独立可跑：
    python3 tools/hw_selftest.py # 分模块全跑，最后给"故障模块 = XXX"
    python3 tools/hw_selftest.py --list # 列出模块
    python3 tools/hw_selftest.py --only serial --verbose
    python3 tools/hw_selftest.py --mock # 无硬件演练（硬件问题降级为 SKIP）
    模块：serial / telemetry / servo / ranging / decision / start_button / odometry /
    motors / velocity / camera / vis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
    [framework.py, m_camera.py, m_decision.py, m_motors.py, m_navigation.py, m_odometry.py, m_ranging.py]
2026-09-15 docs: 审计交付——合规审计 / 代码审计 / 目标达成性 / 部署运维手册 / 可跑复现
    - docs/audit/COMPLIANCE_AUDIT.md：对照智能救援赛项官方要求逐条核查（33 条对照表
    + 23 项不符合，含严重度/证据 文件:行/丢什么分/修法）。
    - docs/audit/COMPLIANCE_AUDIT_REFRESH.md：上述 blocker/high 项在**当前代码**下的时效性复核。
    - docs/audit/CODE_AUDIT.md：全项目代码审计（6 blocker / 12 high / 13+ medium / 9 low）。
    - docs/audit/repro/logic_repro.py：M1~M7 可跑复现脚本（不需要硬件，exit=0）。
    - docs/audit/GOAL_ANALYSIS.md：端到端"能不能拿分"推演，全部结论来自本机实跑。
    - docs/R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
2026-09-15 docs(audit): t11 补 comm_server 入站核验 + 附录（需求侧硬约束六条）
2026-09-15 fix(decision): B8 场心误判会打断目标锁定，导致整场一趟都送不到
    ## 问题（原审计判为"潜伏"，实际是高危）
    `_check_invalid_transport` 旧实现遍历**所有** ACTIVE 目标，只要有任意一个距
    场心 (1500,1500) <500mm 就返回 True。而赛项规则明确"**无效目标由裁判取出、
    重新放在场地中央**"，决赛 25 个目标，场心附近有目标是常态 → 该判据常态误触发。
    后果比"重选目标"严重得多：调用点 `_handle_free_run` 会清空 `_current_target`，
    并在**运送途中**改发 `NAVIGATE_TO`，把导航目标从安全区抢到下一个目标：
    - 那一趟永远到不了投放点（`TRANSPORTING`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
    [verify_s40_s01_team.py]
2026-09-15 fix(全栈): 按审计清单修复 T0/T1/T2 共 34 项（含 4 项待真机实测的刻意保留）
    依据 docs/audit/FULL_PROBLEM_LIST.md 的 T0/T1/T2 分级清单逐条修复，
    涉及 decision / navigation / perception / transport / hardware / states 全链路。
    T0（10/10，全部修复）—— 会导致「整场跑不起来」或「必然丢分」：
    T0-1 空地图提前 WAIT：grip_done/release_done 未完成时不判定结束
    T0-2 堵转误判：异常链改为「有指令速度 且 位移极小」双信号
    T0-3 ANOMALY 进得去出不来：恢复前态 + ANOMALY_MAX_S=8s 兜底
    T0-4 减速带：改按里程判定（BUMP_TRAVEL_MM=450）而非固定超时
    T0-5 视觉不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
    [robot.default.yaml]
2026-09-15 test(tools): 补齐验证器与实机自检——7 套验证 + 分模块现场定位 + 视觉向量
    fix_verifiers（回归护栏，现 7 套全绿）：
    - run_all.py 接入 verify_s40_s01_team.py（第 7 套）
    - verify_s40_s01_team.py：51 条断言，覆盖 S-40/S-01/N-1/S-02/B8/U4/U5/
    N-6/N-7/N-8，含本轮新修的 release-failed 回调链与 clamp_into_area 边界
    - verify_p15_config.py：不再硬编码 DropForward=150（已改 70），改为读 YAML 默认值
    - verify_p1_5_forbidden_zones.py：适配 T1-1 的「可通行点回拉」语义
    - snapshot_sim.py / measure_delivery_rate.py：仿真比分与分场景送达率度量
    hw_selftest（现场「哪个模块坏了」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
    [framework.py, m_accounting.py, m_decision.py, m_navigation.py, measure_delivery_rate.py, run_all.py]
2026-09-15 docs+scripts: 审计交付文档 + 部署运维手册按实机事实订正
    新增审计文档：
    - FULL_PROBLEM_LIST.md：全项目审查总清单，T0(10)/T1(15)/T2(23)/T3(25)
    共 70 条，每条给出 文件:行 + 证据 + 影响 + 建议方向，并逐条标注状态
    （✅34 已修改 / 🟡1 部分 / ⏸4 刻意保留 / 无遗漏），附「刻意保留的条目」
    表（含保留理由与解锁条件）与「本轮修改总结」表
    - INCREMENTAL_AUDIT.md / REVIEW_REPORT.md / VERIFICATION_REPORT.md：
    增量审计、独立复核、独立验证报告
    - S_NEW_NAV_TARGET_CONTRACT.md：导航-决策目标契约变更（按负责人意见保留）
    - COMPLIANCE_AUDIT_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
2026-09-15 docs(audit): 统一回归基线口径 + 订正过期计数 + 补零回退对照证据
    问题：本仓库先后用过**多套仿真 harness**（种子集合与 start_zone 不同），
    导致各文档记的"5 种子序列"互不相同——评审早在 REVIEW_REPORT §6 指出过
    （评审跑仓库脚本得 80/80/80/85/80，文档写 80/80/85/80/80）。
    处置（照评审建议"脚本 + 种子集合 + start_zone"三要素统一口径）：
    - FULL_PROBLEM_LIST.md 新增 §回归基线三要素，确立**唯一对外口径**：
    仓库脚本 snapshot_sim.py、SEEDS=[1,7,42,99,123]、start_zone=1
    → score 80/80/80/85/80、delivered 7/7/7/8/7、valid==delivered、ERROR=0；
    旧口径（临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
2026-09-16 feat(gripper): 适配夹爪 V2（150×100 方形套框 + 后方三块阶梯板）
    机构变更（2026-09-16）：夹爪由旧「U 型槽 + 舵机带单块后方板渐进上调」
    改为「150×100 方形套框 + 后方三块水平阶梯板」。套取方式、舵机行程(0°/70°)、
    单趟容量(1) 均未变。几何数据全部从 STL 实测（2600 面），非口述。
    实测（tools/stl_gripper_probe.py，可复现）：
    · 包围盒 X 160.00 / Y 60.66 / Z 145.00 mm，且 **+Y 才是竖直方向**
    （判据：只有按 Y 为"上"解读，三块板尺寸自上而下才恰好
    157×40 → 150×35 → 150×20 递减，与机构组描述吻合；别的轴都无规律）
    · 套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
    [robot.default.yaml]
2026-09-17 fix(真机): 修复定位链路两处核心错误 + 串口可靠性 + 启动链路（首次 RDK 真机联调）
    2026-09-16 首次把上位机接到 RDK X5 + STM32F103 真机上跑，连续暴露 7 个上位机
    问题。完整排查记录（现象/实测证据/根因/修复）见
    docs/audit/REAL_MACHINE_DEBUG_20260916.md。
    一、定位链路（本轮最关键，两条叠加导致"车一动不动"）
    · START 不清零里程计：协议称"收到 START 后清零局部里程计"，**实测并不会** ——
    发 START 前后 ODOM 与编码器累计值逐位相同：
    前 x=+0.6823 y=+1.0959 θ=-1.7043 enc=(921273,1240079)
    后 完全一致
    而 odom_to_upper() 把 ODOM 当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
    [robot.default.yaml]
2026-09-17 docs(真机): 首次 RDK 真机联调排查与修复全记录 + 固件改动留底
    新增 docs/audit/REAL_MACHINE_DEBUG_20260916.md —— 本轮 9 个问题的
    「现场现象 / 实测证据 / 根因 / 修复 / 状态」全记录，供下次现场直接查表：
    固件侧（2 条，整机变砖级）
    1. MPU6050_Init 失败 → Error_Handler 永久死循环，而 Telemetry_Init 排在其后
    → 遥测一字节不发（表现为"串口能打开但完全没数据"，极易误判为硬件）
    2. UART 接收静默死亡：HAL 在 ORE 后清掉 RXNEIE/EIE，EIE 一清连错误回调都不再
    触发，RxState 停在 BUSY_RX → 接收永久失效而 TX 完全正常。
    实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
    [command.c, main.c]
2026-09-17 固件入库：STM32 工程自有代码纳入版本控制，取代 firmware_patches 留底
    此前固件只存在于开发机的 Windows 目录
    (C:\Users\Tony Huang\rescue_f103c8)，不在仓库内、也没有版本控制。
    而 2026-09-16 真机联调在固件里修的两个问题都是"整机变砖"级别的 ——
    那份目录一旦丢失或被旧版本覆盖，症状（串口一个字节都没有 / 车完全不受控）
    会原样复发且极难重新定位。因此把工程自有代码整体入库。
    - firmware/Core/** 15 个 .c + 13 个 .h（含本轮两处修复）
    - firmware/CMakeLists.txt CMakePresets.json cmake/ .ld startup .ioc
    - firmware/.gitignore 排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
    [chassis.c, chassis_config.h, command.c, encoder.c, encoder.h, main.c]
2026-09-17 补上仓库缺失的启动入口 run.sh + 全量核查仓库与 RDK 的同步状态
    起因：核对"仓库与 RDK 是否一致"时做的是全量逐字节比对（两侧各
    find -type f → LC_ALL=C sort → md5sum → diff 清单），而不是抽查。
    结果 src/ config/ tools/ scripts/ docs/ tests/ firmware/ 与根目录文档
    全部逐字节一致，只暴露出 3 处差异，其中一处是真缺陷：
    * run.sh 只存在于 RDK 的 ~/rescue/ 下，从未进过仓库。
    而 docs/RUNBOOK.md:293 与 docs/audit/REAL_MACHINE_DEBUG_20260916.md §4
    都在教人执行 ./run.sh —— 照文档做第一步就是 No such file or directory。
    RDK 的 SD 卡一旦损坏/换卡，这个唯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
2026-09-17 记录单片机同步核查结果：源↔构建已验证，构建↔芯片受 SWD 链路阻塞
    同步目标是确认 MCU 里跑的就是仓库 firmware/ 这份源码编出的镜像，
    分两段核查，前一段通过、后一段受阻，把证据全部落档。
    ① 源 ↔ 构建 ✅
    仓库 firmware/Core vs Windows 构建源 Core：28/28 个 .c/.h 逐字节一致；
    main.c 14:54:45 → main.c.obj 14:57:27、command.c 15:56:06 →
    command.c.obj 15:56:12、elf 链接于 15:56:13 —— 两处修复的目标文件
    都晚于各自源码，且 elf 晚于所有源码，即镜像含修复1(IMU降级)+修复2(RX看门狗)。
    留档 elf md5 419cd36b70aeaa897789151dda3b1500 / 1049584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
2026-09-17 留档同步过程中的一次 rsync 操作失误：源目录漏尾斜杠导致嵌套
    rsync -az --delete docs rdk:~/rescue/docs/ —— 源目录末尾漏了 /，
    语义从"同步 docs 的内容"变成"把 docs 这个目录放进 DEST"，
    于是在 RDK 上生成了嵌套的 ~/rescue/docs/docs/，而顶层那份没被更新。
    表现是"rsync 成功退出但文件没变"。
    这次没造成损失(嵌套副本内容其实是新的)，但同一写法配 --delete 能真删文件，
    属高危操作。已处置：删嵌套目录 + 用 docs/ (源带斜杠) 重同步，md5 复核一致。
    教训：rsync 加 --delete 后两端尾斜杠必须当语法读；且成功退出的退出码
    不能证明同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
2026-09-17 单片机同步完成：只读读回比对证明芯片镜像与仓库源码逐字节一致
    SWD 恢复后改用只读办法做字节级校验（比 -w -v 更强：它证明"芯片此刻
    就已经是这份镜像"，而不是"写入后变成了这份镜像"）：
    objcopy -O binary <elf> fw_from_elf.bin → 37548 字节
    STM32_Programmer_CLI -u 0x08000000 37548 ... → 只读读回
    cmp → 零差异
    两侧 md5 均为 d7645a16e6c6fd64277fdc3bc5a817da，37548 字节 ≈ 64K 的 57.3%，
    与编译日志 FLASH 57.29% 吻合。至此 仓库/RDK/MCU 三者一致。
    顺带查清并留档两件事：
    1) 一度连不上的真因不是接线，是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
2026-09-17 现场启动不再需要手算车头朝向：由出发区自动推导 + 新增 start.sh 一键入口
    问题（用户提出）：每换一个出发区和安全区，就好像"要改程序才能跑"。
    实际核查后确认：出发区(START_ZONE)、颜色(TEAM_COLOR)本来就都是环境变量，
    真正每次需要人工介入的是 **车头朝向 START_HEADING_DEG 必须手算再填**。
    而这个角度是出发区的**纯函数**（= 从区中心指向该区外侧角的方向），
    本就不该由人每次现算 —— 手算多一个环节就多一次填错机会，而填错的代价是
    **整张地图旋转错**（位姿跑到场外 / A* 起点不可通行 / 车一动不动）。
    更糟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
    [main.py, verify_b1_start_zone.py]
2026-09-17 搜索算法改为「中央优先 + 全场蛇形覆盖」：确定性计划取代无记忆随机取点
    依据：赛规第16页现场布置图（图7）显示 20 个目标紧凑堆在场地正中。
    像素级量得排布为 6 格×4 格、每格≈40mm ⇒ 约 240×160mm，物体之间紧挨着：
    绿8(普通物资) + 黑三角4(核心物资正三棱锥，俯视即三角) + 橘4(伤员，各占两格)
    + 蓝4(危险目标) = 20，与第17页文字数量完全吻合。
    原算法（_get_explore_target）四个问题：
    1 纯随机无记忆 → 反复走同一片、无覆盖保证；
    2 随机范围实际只有 [900,2100]²(占全场16%) → 外圈900mm环带永远搜不到；
    3 clamp(200,2800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
    [run_all.py, verify_p1_8_watchdog.py, verify_search_coverage.py]
2026-09-17 修复套取链：不开套/压到车下/开局误报急停（含 2Hz 诊断日志）
    现场症状（日志 09:12:28-09:14:49，4 号区）：
    ① "识别到物体却不去套，反而移动一段距离，之后物体就不在视野里了"
    ② "物体堆卡在车下"
    ③ "一进 AUTONOMOUS 就报 NO_ACTION_15S → EMERGENCY_STOP"
    真线索是日志里 cmd v=0mm/s 却能触发"已下发速度但无位移"告警 ——
    自相矛盾说明"有角速度、没有线速度"，即车在原地转。据此定位出 5 处缺陷：
    A motion_control: linear *= (1-angle_ratio)，角度误差 ≥25.8° 时前进被压成 0。
    B 近距仍要求"先对准"：方位角误差 ≈ atan(位置抖动/距离)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
    [config.py, m_accounting.py, m_transport.py, run_all.py]
2026-09-17 安全修复：硬件自检的舵机模块缺少动作闸门，会不加确认就真动夹爪
    事故：今天在 RDK 上直接跑 `python3 tools/hw_selftest.py`（既没 --mock 也没
    --yes-motion），小车动了 —— 是**夹爪舵机**在动：m_servo 执行了
    SERVO,RAISE / LOWER / HOLD 与 SERVO,ANGLE,0/35/70。
    准确的账（已逐个模块审计）：
    · **轮子没有被驱动**。三个会驱动车轮的模块 m_motors / m_odometry / m_velocity
    **都有** `ctx.need_motion()` 闸门，未给 --yes-motion → 全部 SKIP。
    · **m_servo 缺这个闸门** —— 它只调 `ctx.require_cli()`，于是照常发舵机命令。
    这是一处真缺陷：一个会物理移动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
    [framework.py, m_servo.py]
2026-09-17 安全修复（根因）：--mock 反而解锁了动作闸门，且照样打开真实串口
    上一提交只补了 m_servo 的闸门，**根因没修对**。用户补充说明"先看到夹爪在动，
    然后轮子开始转、小车往前走"，据此重新穷尽排查，找到真正的两处叠加缺陷：
    ① `Ctx.need_motion()` 第一行是 `if self.mock: return None` —— **--mock 把
    "会驱动执行机构"的闸门直接放行了**；
    ② `open_chassis()` / `raw_serial()` **根本不看 mock**，照样打开真实 /dev/ttyS1。
    于是 `--mock` 不但没保护，反而**解锁**了 servo / odometry / motors / velocity
    四个模块，按模块顺序对着真车发指令 ——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
    [framework.py, run_all.py, verify_selftest_safety.py]
2026-09-17 修两个"自检说谎"：TEL 期望字段数抄错 + 舵机助手把 ERR 应答吃掉了
    用户要求查那三个 FAIL 里的另外两个。查完结论：**两个都是自检脚本自己的 bug，
    固件没有问题**。两次都差点让人去追不存在的固件缺陷。
    ① `TEL 字段数 8（期望 10）` → **8 才是对的**
    协议 chassis_serial_protocol.md:448 定义
    TEL,tick_ms,left_target_rpm,left_actual_rpm,right_target_rpm,
    right_actual_rpm,left_pwm,right_pwm
    即 TEL + 7 个值 = 8 个逗号段；固件 telemetry.c 的格式串
    "TEL,%lu,%d,%s%lu.%03lu,%d,%s%lu.%03lu,%d,%d"
    数出来也是 8 段；实测行 TEL,4409605,0,0.000,0,0.000,0,0 也是 8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
    [m_servo.py, m_telemetry.py, run_all.py, verify_selftest_truthfulness.py]
2026-09-18 舵机标定85度
2026-09-18 修复 5 个"整场白跑"级现场 bug + 新增实时画面与定位标定工具
    每个 bug 都有现场日志实证，并补了**在旧代码上会失败**的护栏。
    ## 主控循环第一帧就死（UnboundLocalError: 'now'）
    `_run_once` 里 `now` 只在「状态==DONE」分支赋值，却在末尾 2Hz 诊断日志里无条件使用
    → 策略状态非 DONE 时第一帧抛异常 → 车倒车进场后一动不动（222 帧全在崩，
    但 `_main_loop` 只打印第 1 次与每 250 次，所以日志写"累计 1 次"）。
    既有验证为何漏掉：m_decision 调 `_run_once` 前先把状态造成"时间到"，正文一行没跑；
    仿真走 integrated_sim.py 另写了一遍循环；pyfl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
    [framework.py, m_pickplace.py]
2026-09-18 舵机行程同步为 0°/85°：补上残留描述 + 加跨"上位机↔固件↔协议"一致性护栏
    队友已把固件 `SERVO_RAISED_ANGLE_DEG` 与上位机 `ANGLE_RAISED_DEG` 由 70° 改成 85°
    （脉宽 1778→1944us）。本次补齐剩下没跟上的地方，并把它做成护栏防止以后再飘。
    ## 同步的残留描述
    - `config/robot.default.yaml`：三处注释仍写"0° 套住 / 70° 释放"，
    运维时按 YAML 读会被误导 → 改为 0°/85° 并注明现场标定日期与固件出处
    - `docs/audit/FULL_PROBLEM_LIST.md`：那句"舵机行程（0°/70°）均未变"现在是错的
    → 更正为"已标定为 0°/85°"，并显式标注 `CODE_AUDIT.md` /
    `COMPLIA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
    [robot.default.yaml]
2026-09-19 修正队伍方向：本队送**蓝方安全区**（不是红方）+ 加"出发区↔安全区颜色"一致性防呆
    现场指出：比赛时物资是送**蓝方安全区**，而此前一路用的是 `TEAM_COLOR=red`。
    ## 为什么之前一直错
    场地几何是死的：出发区 1/2 在**上半场**、3/4 在**下半场**；
    **红安全区在顶部中央（y 2670~2970）、蓝安全区在底部中央（y 30~330）**。
    所以 4 号区（右下角）对应的本队安全区在**脚下**（蓝），红方则是 1/2 号区。
    而日志里原来只有一句"请与现场实际颜色核对"，很容易滑过去。
    生产代码本身**两侧都支持**（`DecisionEngine._get_supply_area_positio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
    [m_pickplace.py, main.py, verify_run_once_loop.py]
2026-09-19 启动时补一行正向确认：出发区半场↔安全区颜色一致时也明确打印
    原实现只在**不一致**时打 🚨，一致时一句不说 —— 现场需要的是
    「我怎么知道填对了」的答案，只在出错时才说话会让人一直不确定。
    2026-09-18 那场就是被这个坑掉的（START_ZONE=4 配了 red，无人察觉）。
    现在会打印：出发区 4 号在下半场（3/4 号区） → 本队安全区 BLUE（底部中央）与场地几何一致 ✅
2026-09-19 修复启动崩溃：一致性检查的辅助函数必须放模块级、检查放在 start_zone 解析之后
    我上一版把 zone_team_color_mismatch 定义插在了 main() 函数体中间 ——
    Python 里它后面的 4 空格缩进代码全成了它的函数体，main() 被截断成 13 条语句、
    启动 0.1 秒就正常 return（不报任何错）。更早那版则是 start_zone 尚未赋值就使用 → NameError。
    两次都是全部闸门全绿：没有任何一项验证会真正执行 main()。
    故新增 tools/fix_verifiers/verify_startup_smoke.py（真起子进程跑 main()，
    断言走到 BOOT、断言正向确认行与错配告警），并已接入 run_all。
    用 4cb926c 的坏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
    [main.py, run_all.py, verify_startup_smoke.py]
